gallicchio/GPiBridge/docs/images/board_bottom.png

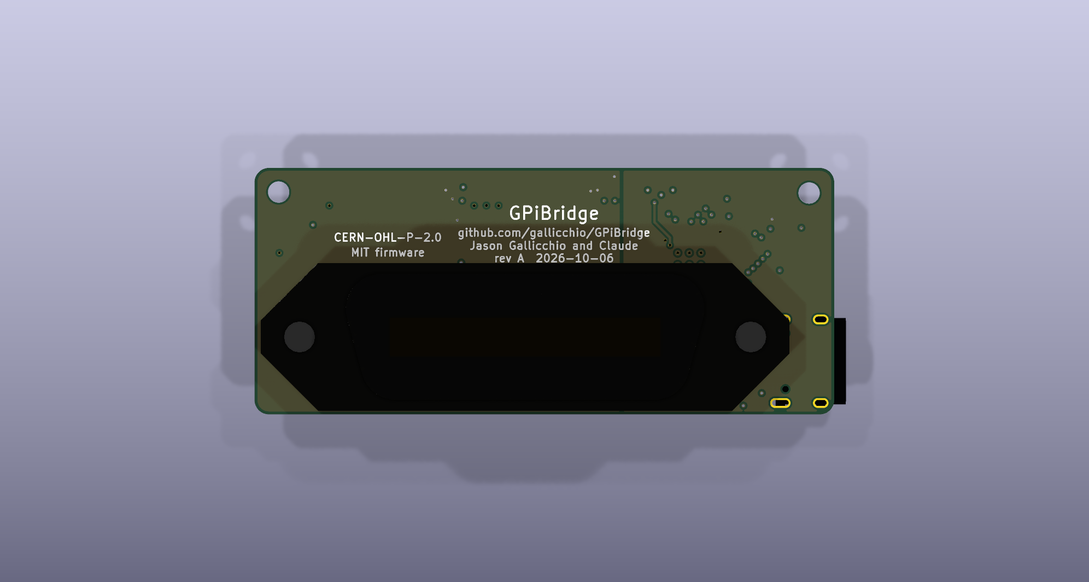
docs/images/board_bottom.png
