gallicchio/GPiBridge/docs/images/housing_front.png

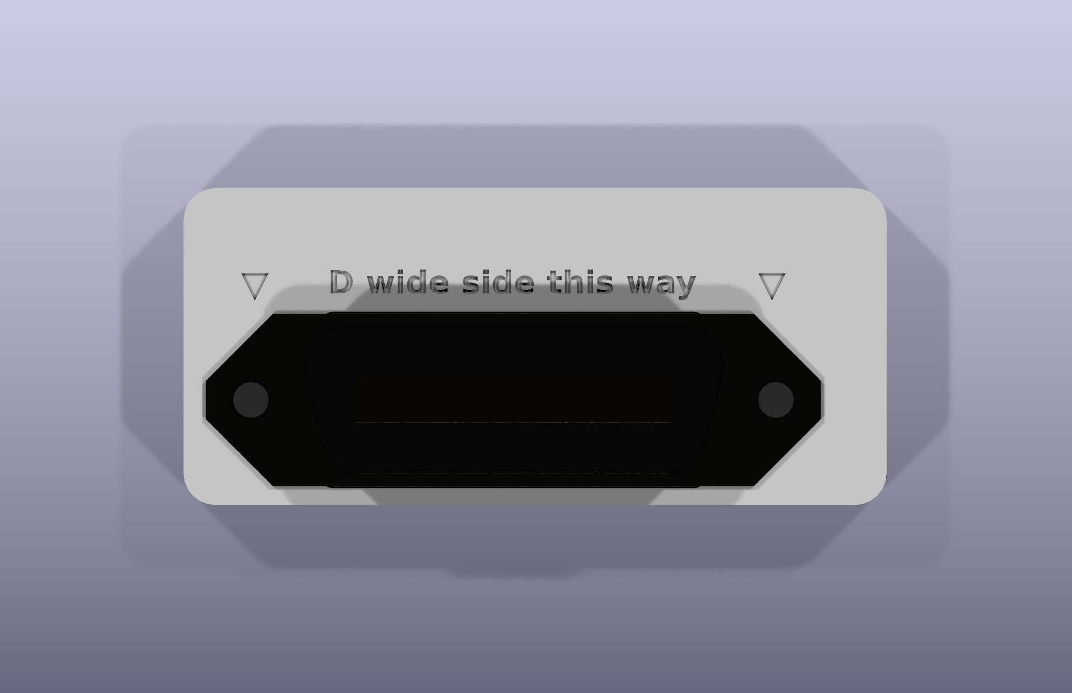
docs/images/housing_front.png
