gallicchio/GPiBridge/docs/images/housing_usb_end.png

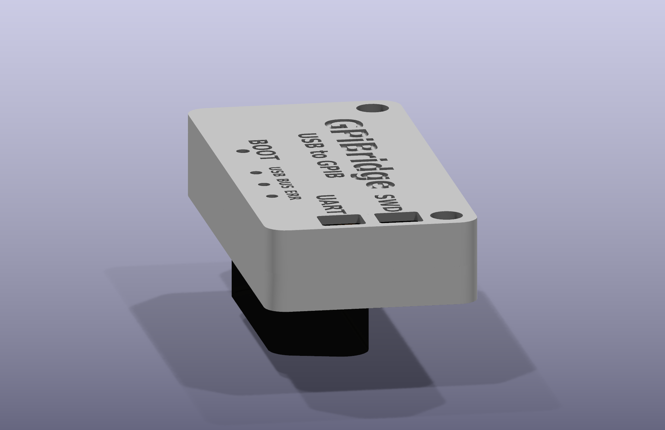
docs/images/housing_usb_end.png
