gallicchio/GPiBridge/docs/images/lite_schematic.png

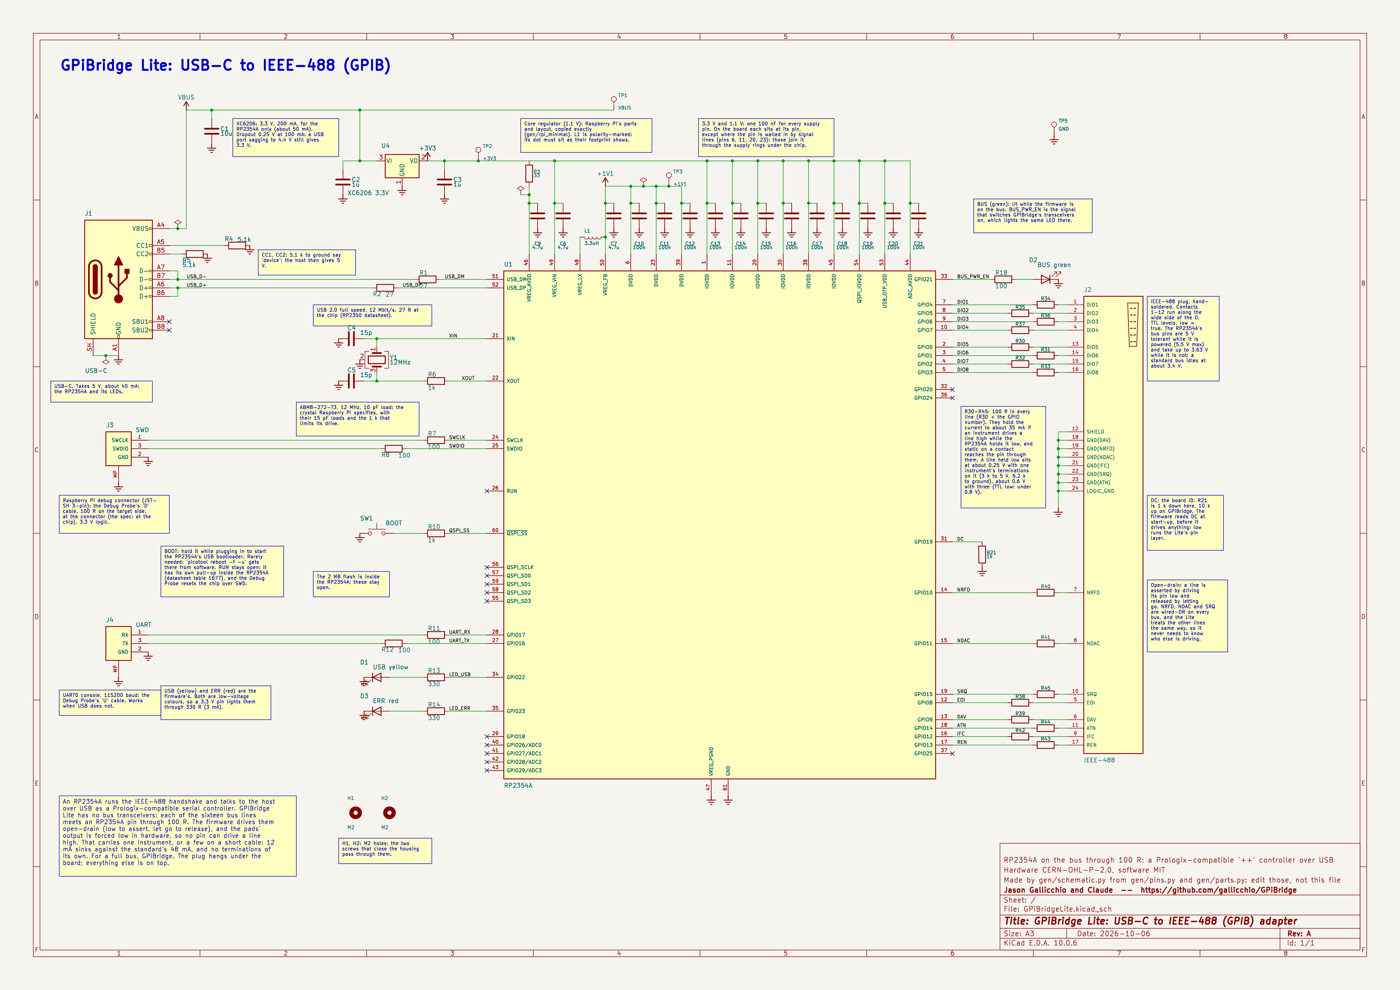
docs/images/lite_schematic.png
