gallicchio/GPiBridge/docs/images/schematic.png

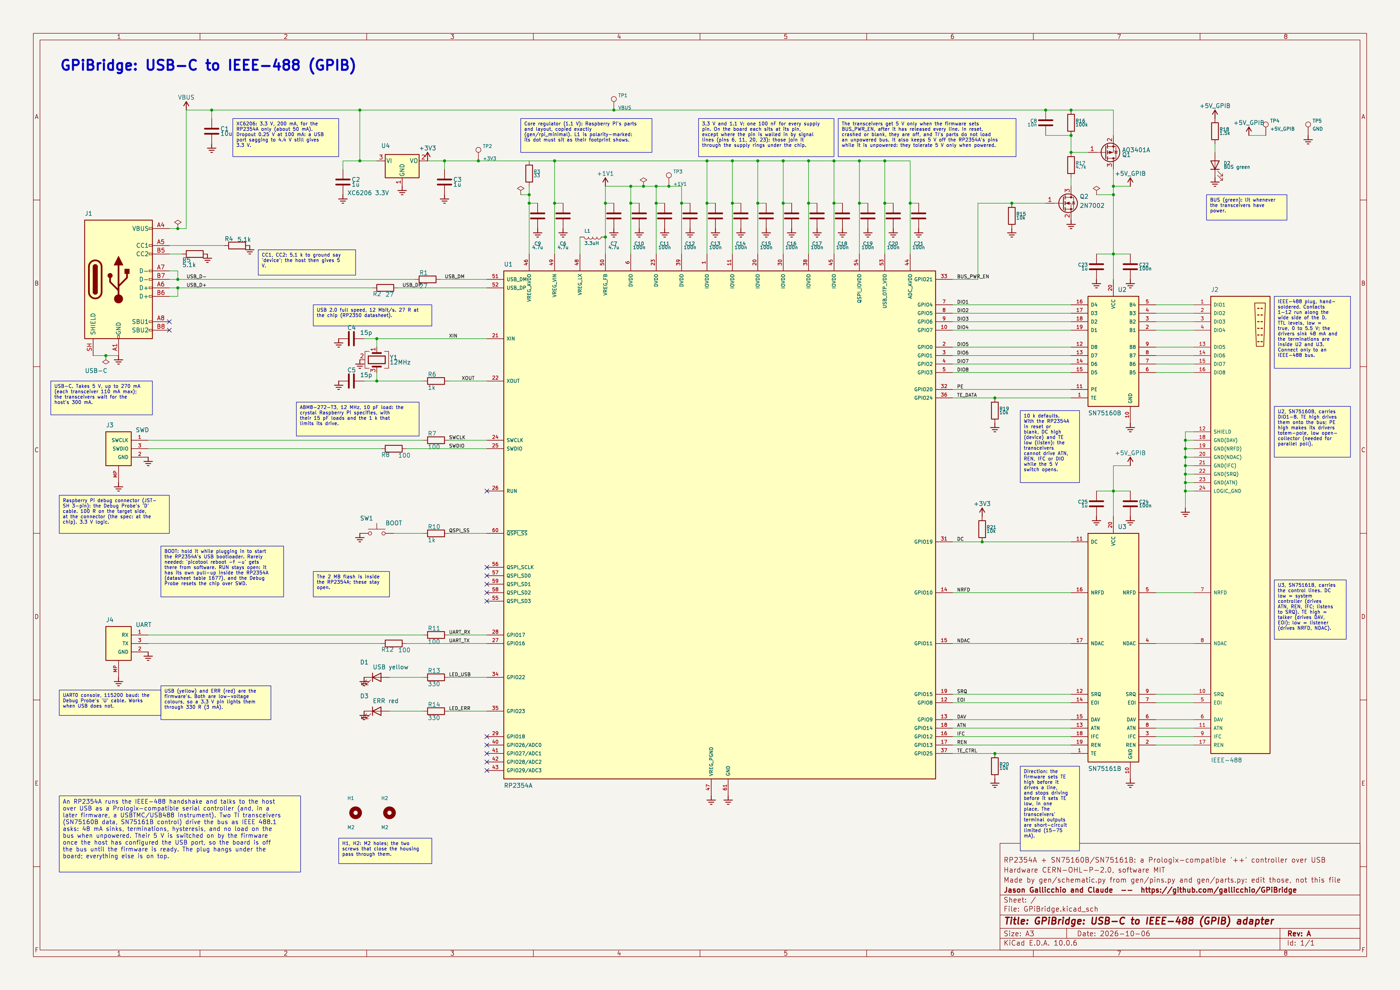
docs/images/schematic.png
