gallicchio/GPiBridge/enclosure/out/render_top.png

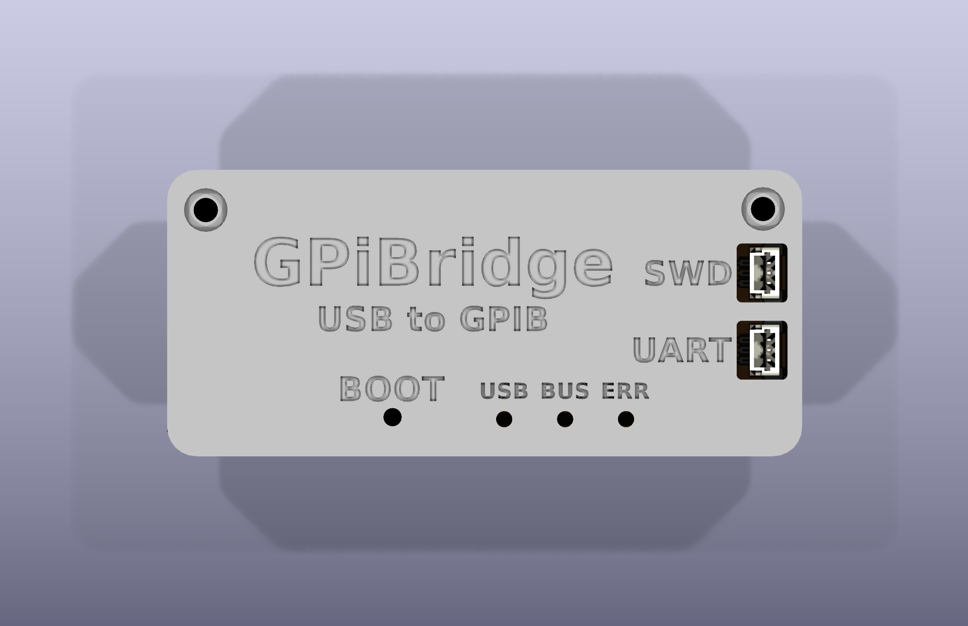
enclosure/out/render_top.png
