gallicchio/GPiBridge/mfg/release-lite/GPiBridgeLite_bom.csv

Comment | Designator | Footprint | LCSC Part #
100 | R7,R8,R11,R12,R18,R30,R31,R32,R33,R34,R35,R36,R37,R38,R39,R40,R41,R42,R43,R44,R45 | R_0402_1005Metric | C25076
100n | C10,C11,C12,C13,C14,C15,C16,C17,C18,C19,C20,C21 | C_0402_1005Metric | C1525
1k | R6,R10,R21 | R_0402_1005Metric | C11702
4.7u | C6,C7,C9 | C_0402_RPi_wide | C23733
15p | C4,C5 | C_0402_1005Metric | C1548
SWD/UART | J3,J4 | JST_SH_BM03B-SRSS-TB_1x03-1MP_P1.00mm_Vertical | C160389
27 | R1,R2 | R_0402_1005Metric | C25100
330 | R13,R14 | R_0402_1005Metric | C25104
5.1k | R4,R5 | R_0402_1005Metric | C25905
1u | C2,C3 | C_0402_1005Metric | C52923
USB-C | J1 | USB_C_Receptacle_HRO_TYPE-C-31-M-12 | C165948
10u | C1 | C_0603_1608Metric | C19702
12MHz | Y1 | Crystal_SMD_3225-4Pin_3.2x2.5mm | C20625731
USB yellow | D1 | LED_0805_2012Metric | C2296
BUS green | D2 | LED_0805_2012Metric | C2297
33 | R3 | R_0402_RPi | C25105
RP2354A | U1 | RP2350A_QFN-60_7x7mm_P0.4mm_RPi | C41378174
3.3uH | L1 | L_Abracon_AOTA-B201610_RPi | C42411119
XC6206 3.3V | U4 | SOT-23-3 | C5446
BOOT | SW1 | SW_SPST_TS-1088-xR020 | C720477
ERR red | D3 | LED_0805_2012Metric | C84256
