gallicchio/GPiBridge/enclosure/out/gpibridge_lid.step

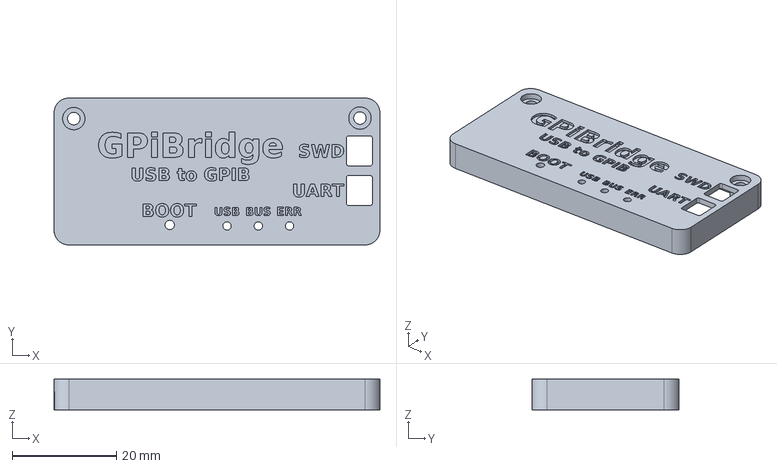
[picture p12: CAD file, 2026-10-07]
enclosure/out/gpibridge_lid.step
62.6 x 28.2 x 5.90 mm
