gallicchio/GPiBridge/enclosure/out/gpibridge_base.step

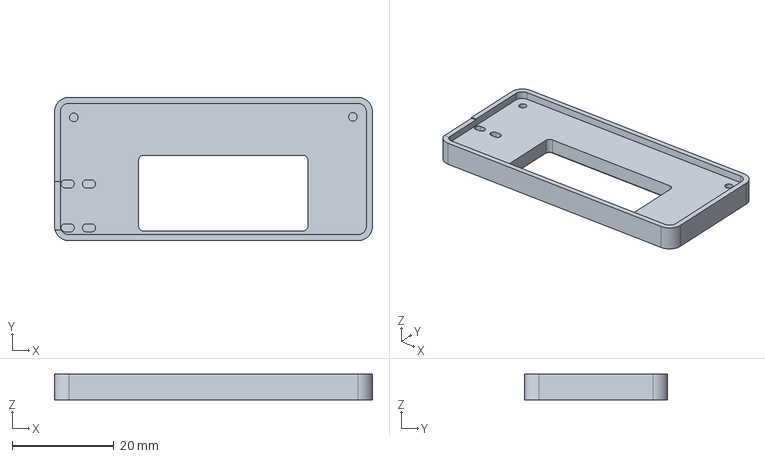
[picture p13: CAD file, 2026-10-07]
enclosure/out/gpibridge_base.step
62.6 x 28.2 x 5.10 mm
