gallicchio/GPiBridge/(list of files, cad)

Other CAD files:
enclosure/out/gpibridge_lite_lid.step
enclosure/out/gpibridge_base.stl
enclosure/out/gpibridge_lid.stl
enclosure/out/gpibridge_lite_lid.stl
