gallicchio/GPiBridge/docs/GPiBridge_schematic.pdf

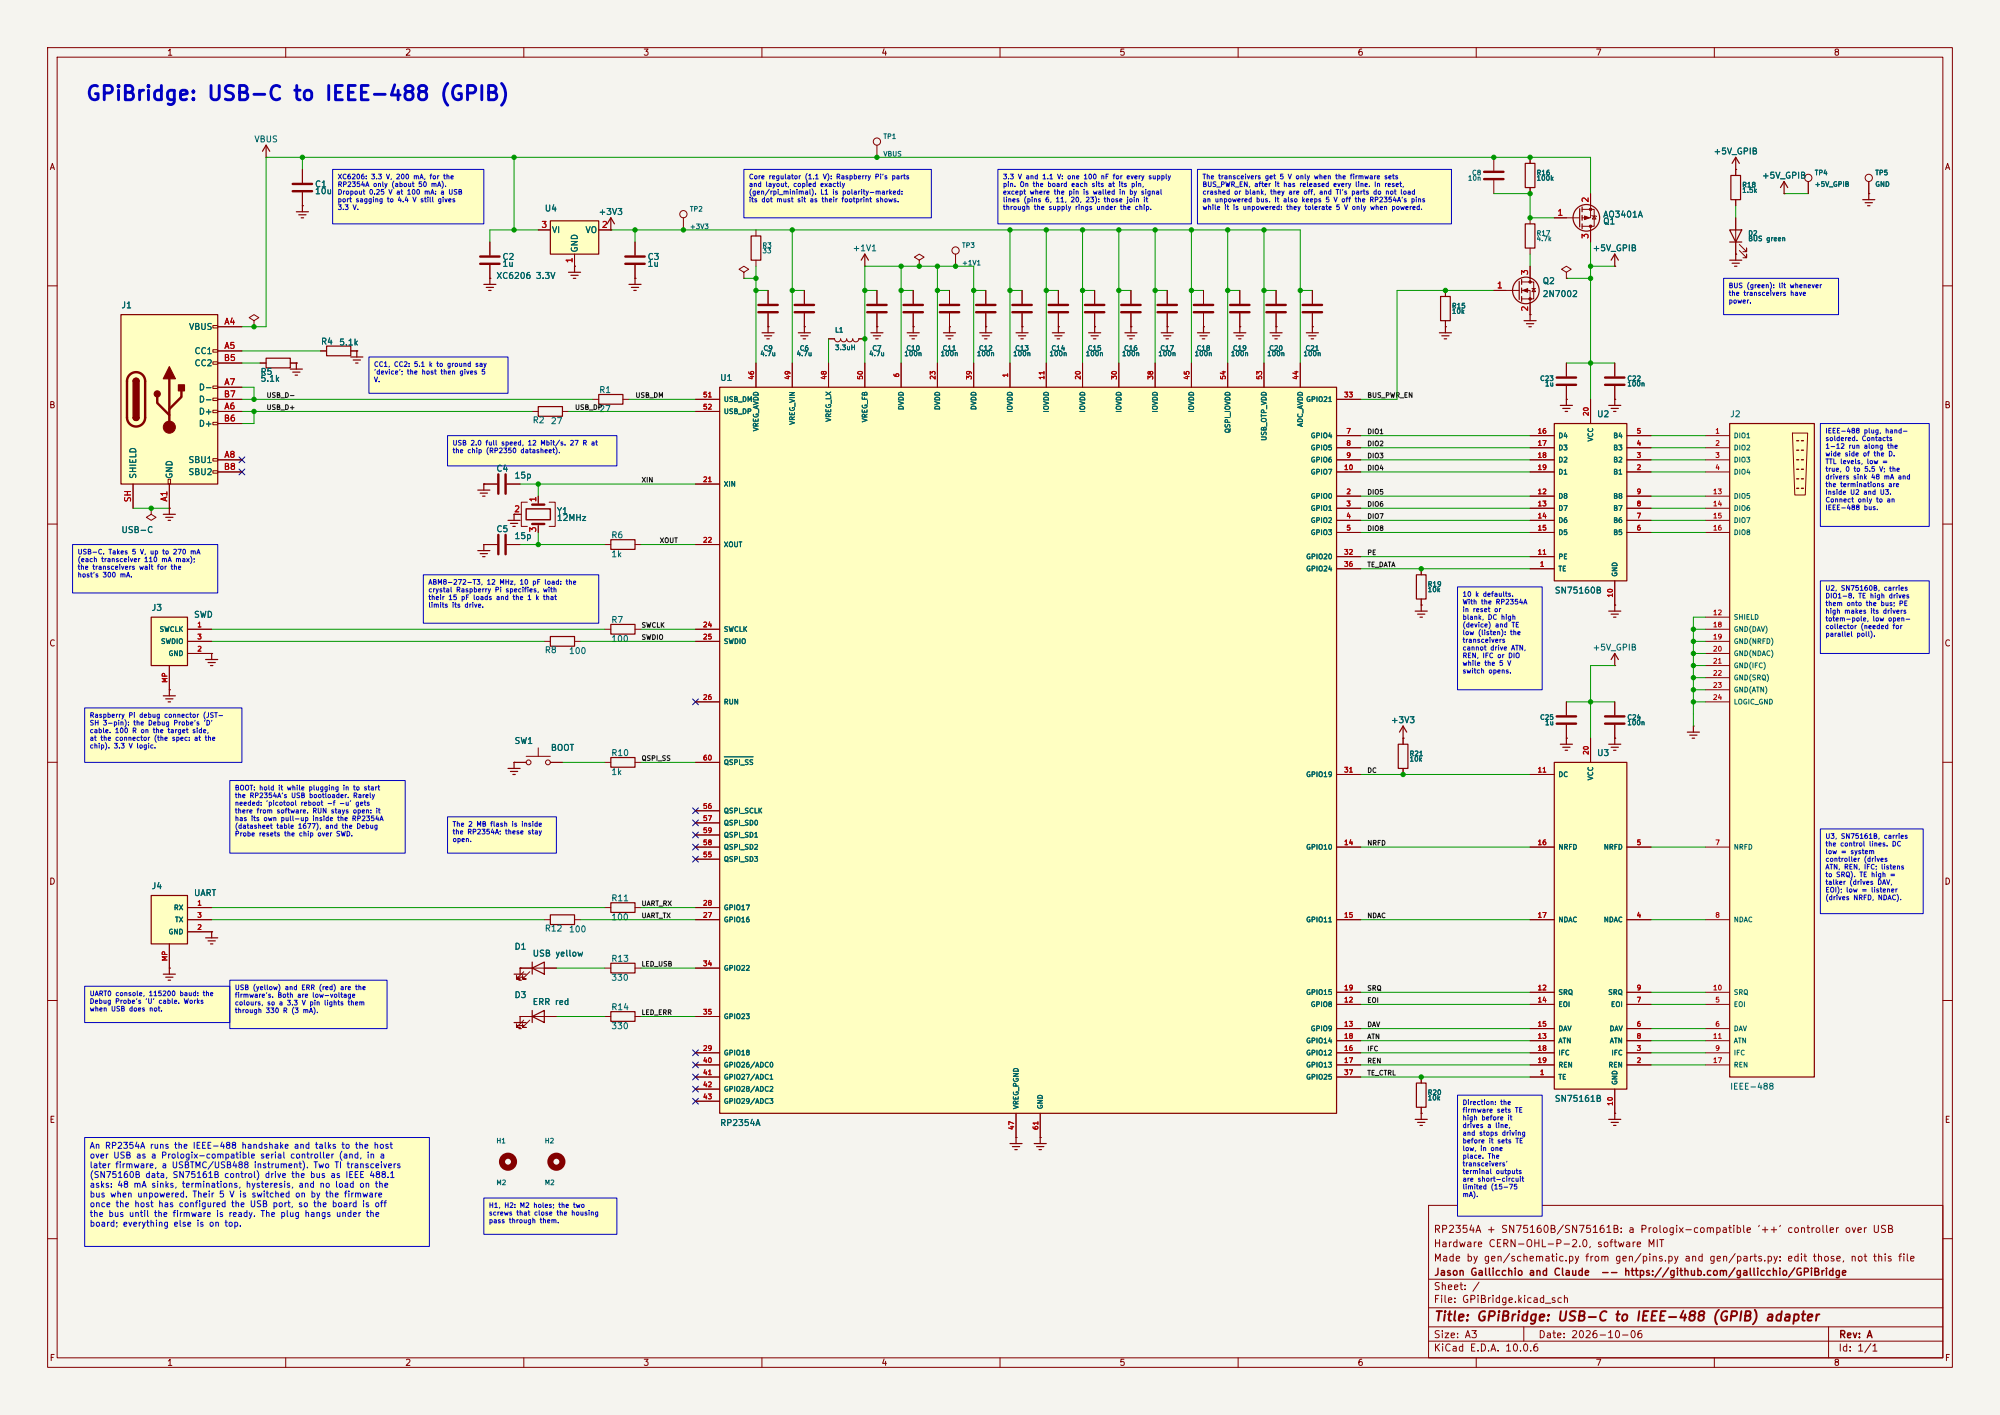
[picture p14: page 1]

GPiBridge: USB-C to IEEE-488 (GPIB)

the transceivers have power. XC6206: 3.3 V, 200 mA, for the RP2354A only (about 50 mA). Dropout 0.25 V at 100 mA: a USB

V. The transceivers get 5 V only when the firmware sets BUS_PWR_EN, after it has released every line. In reset, crashed or blank, they are off, and TI's parts do not load

Core regulator (1.1 V): Raspberry Pi's parts and layout, copied exactly

3.3 V and 1.1 V: one 100 nF for every supply pin. On the board each sits at its pin, except where the pin is walled in by signal

(gen/rpi_minimal). L1 is polarity-marked:

its dot must sit as their footprint shows. USB-C. Takes 5 V, up to 270 mA

port sagging to 4.4 V still gives 3.3 V.

through the supply rings under the chip. ABM8-272-T3, 12 MHz, 10 pF load: the

lines (pins 6, 11, 20, 23): those join it

CC1, CC2: 5.1 k to ground say
'device'; the host then gives 5
C5 15p C4 15p D1 USB yellow

IEEE-488 plug, hand-
soldered. Contacts 1-12 run along the wide side of the D. TTL levels, low =

true, 0 to 5.5 V; the drivers sink 48 mA and

the terminations are
inside U2 and U3. Connect only to an

crystal Raspberry Pi specifies, with
their 15 pF loads and the 1 k that
limits its drive.

in reset or blank, DC high

them onto the bus; PE
high makes its drivers
totem-pole, low open-
collector (needed for parallel poll).

(device) and TE
low (listen): the
transceivers cannot drive ATN, REN, IFC or DIO

switch opens. The 2 MB flash is inside

(datasheet table 1677), and the Debug Probe resets the chip over SWD. Raspberry Pi debug connector (JST-
SH 3-pin): the Debug Probe's 'D' cable. 100 R on the target side, at the connector (the spec: at the

C251u D3 ERR red D1 USB yellow

BOOT: hold it while plugging in to start
the RP2354A's USB bootloader. Rarely needed: 'picotool reboot -f -u' gets

there from software. RUN stays open: it has its own pull-up inside the RP2354A

the RP2354A; these stay open. An RP2354A runs the IEEE-488 handshake and talks to the host over USB as a Prologix-compatible serial controller (and, in a

the control lines. DC
low = system
controller (drives ATN, REN, IFC; listens

to SRQ). TE high =
talker (drives DAV, EOI); low = listener (drives NRFD, NDAC).

USB (yellow) and ERR (red) are the
firmware's. Both are low-voltage
colours, so a 3.3 V pin lights them
through 330 R (3 mA).

UART0 console, 115200 baud: the Debug Probe's 'U' cable. Works when USB does not.

firmware sets TE
high before it drives a line, and stops driving

before it sets TE
low, in one place. The

later firmware, a USBTMC/USB488 instrument). Two TI transceivers
(SN75160B data, SN75161B control) drive the bus as IEEE 488.1
asks: 48 mA sinks, terminations, hysteresis, and no load on the bus when unpowered. Their 5 V is switched on by the firmware once the host has configured the USB port, so the board is off

transceivers' terminal outputs are short-circuit

H1, H2: M2 holes; the two
screws that close the housing

the bus until the firmware is ready. The plug hangs under the board; everything else is on top.

RP2354A + SN75160B/SN75161B: a Prologix-compatible '++' controller over USB
Hardware CERN-OHL-P-2.0, software MIT
Made by gen/schematic.py from gen/pins.py and gen/parts.py: edit those, not this file
Jason Gallicchio and Claude -- https://github.com/gallicchio/GPiBridge
Sheet: /
File: GPiBridge.kicad_sch
Title: GPiBridge: USB-C to IEEE-488 (GPIB) adapter

Size: A3 | Rev: A | F Date: 2026-10-06
KiCad E.D.A. 10.0.6 | Id: 1/1
