gallicchio/GPiBridge/docs/GPiBridgeLite_schematic.pdf

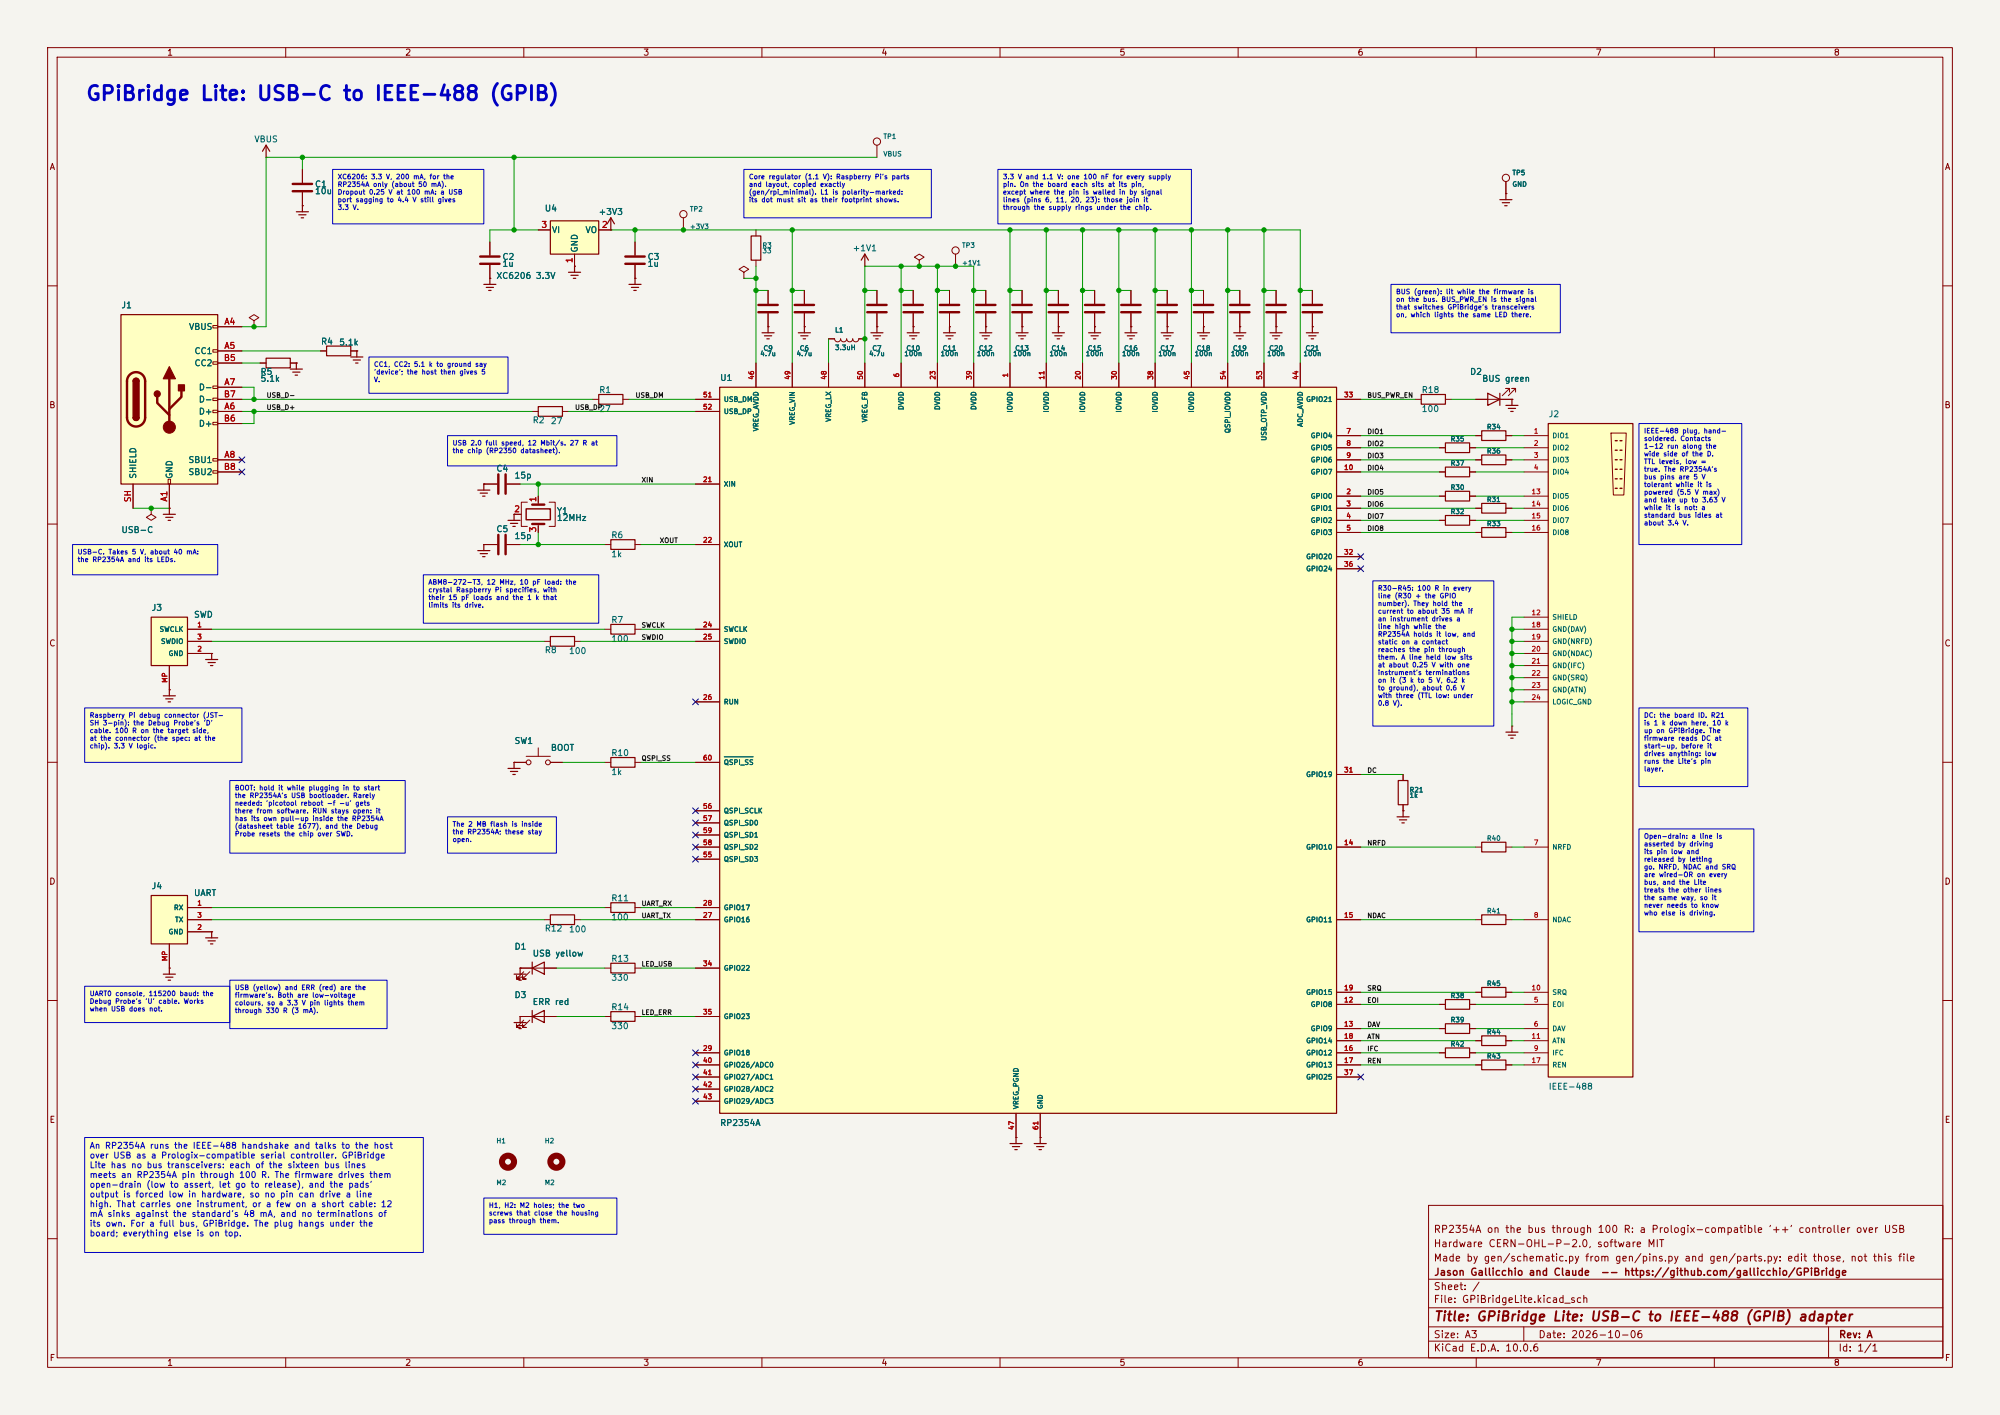
[picture p15: page 1]

chip). 3.3 V logic. GPiBridge Lite: USB-C to IEEE-488 (GPIB)

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

Core regulator (1.1 V): Raspberry Pi's parts and layout, copied exactly

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

(gen/rpi_minimal). L1 is polarity-marked:
its dot must sit as their footprint shows.

lines (pins 6, 11, 20, 23): those join it
through the supply rings under the chip.

CC1, CC2: 5.1 k to ground say
'device'; the host then gives 5
V. ABM8-272-T3, 12 MHz, 10 pF load: the

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

to ground), about 0.6 V with three (TTL low: under 0.8 V). USB 2.0 full speed, 12 Mbit/s. 27 R at

true. The RP2354A's bus pins are 5 V

tolerant while it is powered (5.5 V max) and take up to 3.63 V while it is not: a

standard bus idles at about 3.4 V.

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

line (R30 + the GPIO
number). They hold the
current to about 35 mA if an instrument drives a

line high while the RP2354A holds it low, and

static on a contact reaches the pin through

them. A line held low sits at about 0.25 V with one

instrument's terminations on it (3 k to 5 V, 6.2 k

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

is 1 k down here, 10 k up on GPiBridge. The

firmware reads DC at start-up, before it drives anything: low

runs the Lite's pin
layer.

who else is driving. BOOT: hold it while plugging in to start
the RP2354A's USB bootloader. Rarely needed: 'picotool reboot -f -u' gets

there from software. RUN stays open: it has its own pull-up inside the RP2354A
(datasheet table 1677), and the Debug Probe resets the chip over SWD.

the RP2354A; these stay open.

its pin low and
released by letting
go. NRFD, NDAC and SRQ
are wired-OR on every bus, and the Lite

treats the other lines
the same way, so it never needs to know

its own. For a full bus, GPiBridge. The plug hangs under the board; everything else is on top. USB (yellow) and ERR (red) are the
UART0 console, 115200 baud: the Debug Probe's 'U' cable. Works when USB does not. An RP2354A runs the IEEE-488 handshake and talks to the host over USB as a Prologix-compatible serial controller. GPiBridge

firmware's. Both are low-voltage
colours, so a 3.3 V pin lights them

Lite has no bus transceivers: each of the sixteen bus lines meets an RP2354A pin through 100 R. The firmware drives them

open-drain (low to assert, let go to release), and the pads'
output is forced low in hardware, so no pin can drive a line high. That carries one instrument, or a few on a short cable: 12 mA sinks against the standard's 48 mA, and no terminations of

H1, H2: M2 holes; the two
screws that close the housing
pass through them.

RP2354A on the bus through 100 R: a Prologix-compatible '++' controller over USB
Hardware CERN-OHL-P-2.0, software MIT
Made by gen/schematic.py from gen/pins.py and gen/parts.py: edit those, not this file
Jason Gallicchio and Claude -- https://github.com/gallicchio/GPiBridge
Sheet: /
File: GPiBridgeLite.kicad_sch
Title: GPiBridge Lite: USB-C to IEEE-488 (GPIB) adapter

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
