gallicchio/GPiBridge/mfg/release-lite/GPiBridgeLite_assembly_bottom.pdf

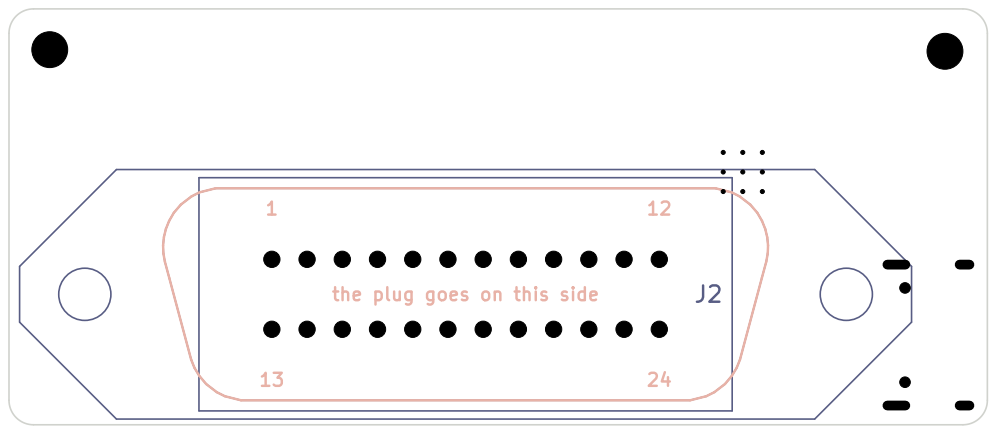
[picture p16: page 1]
