gallicchio/GPiBridge/mfg/release-lite/GPiBridgeLite_assembly_top.pdf

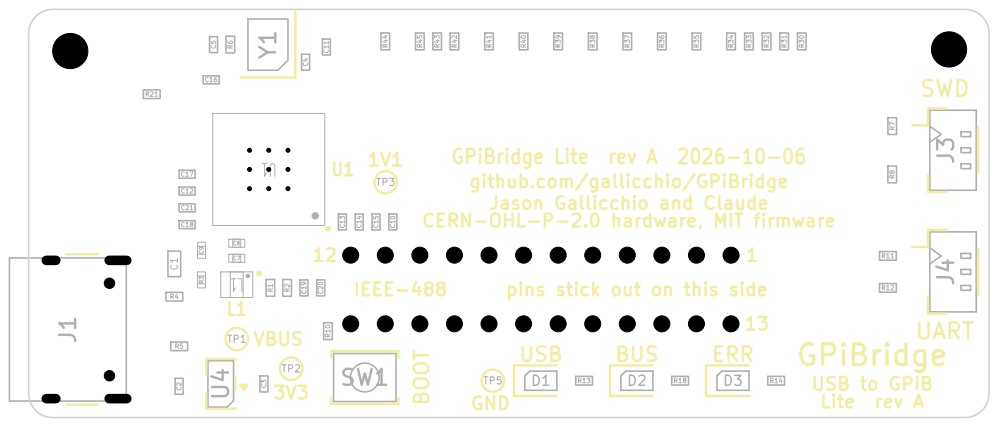
[picture p17: page 1]

github.com/gallicchio/GPiBridge
Jason Gallicchio and Claude CERN-OHL-P-2.0 hardware, MIT firmware pins stick out on this side1
