gallicchio/GPiBridge/mfg/release/GPiBridge_assembly_bottom.pdf

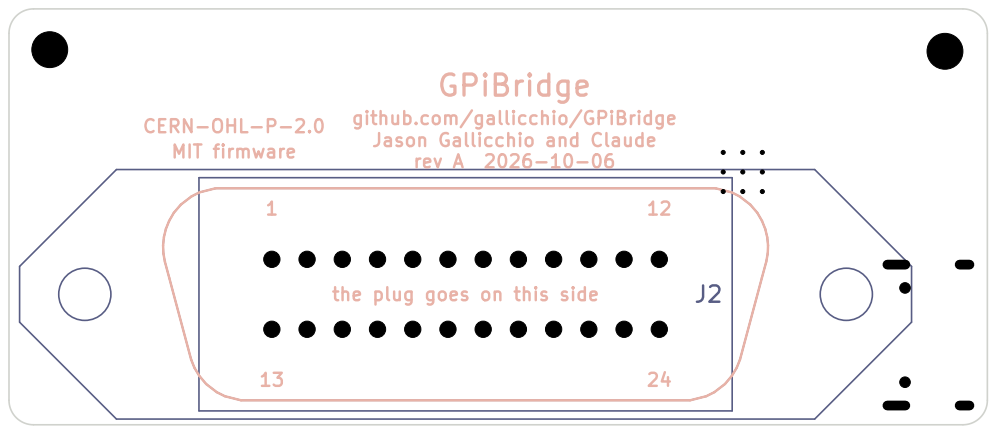
[picture p18: page 1]

github.com/gallicchio/GPiBridge
Jason Gallicchio and Claude
rev A 2026-10-06
