gallicchio/GPiBridge/mfg/release/GPiBridge_assembly_top.pdf

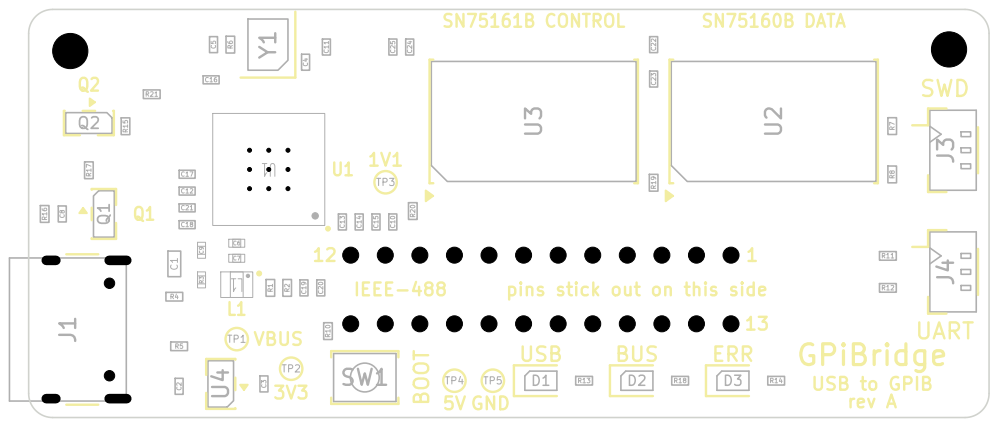
[picture p19: page 1]

pins stick out on this side1
