gallicchio/GPiBridge/hardware/GPiBridge.kicad_pcb

## KiCad design hardware/GPiBridge.kicad_pcb (2026-10-07)

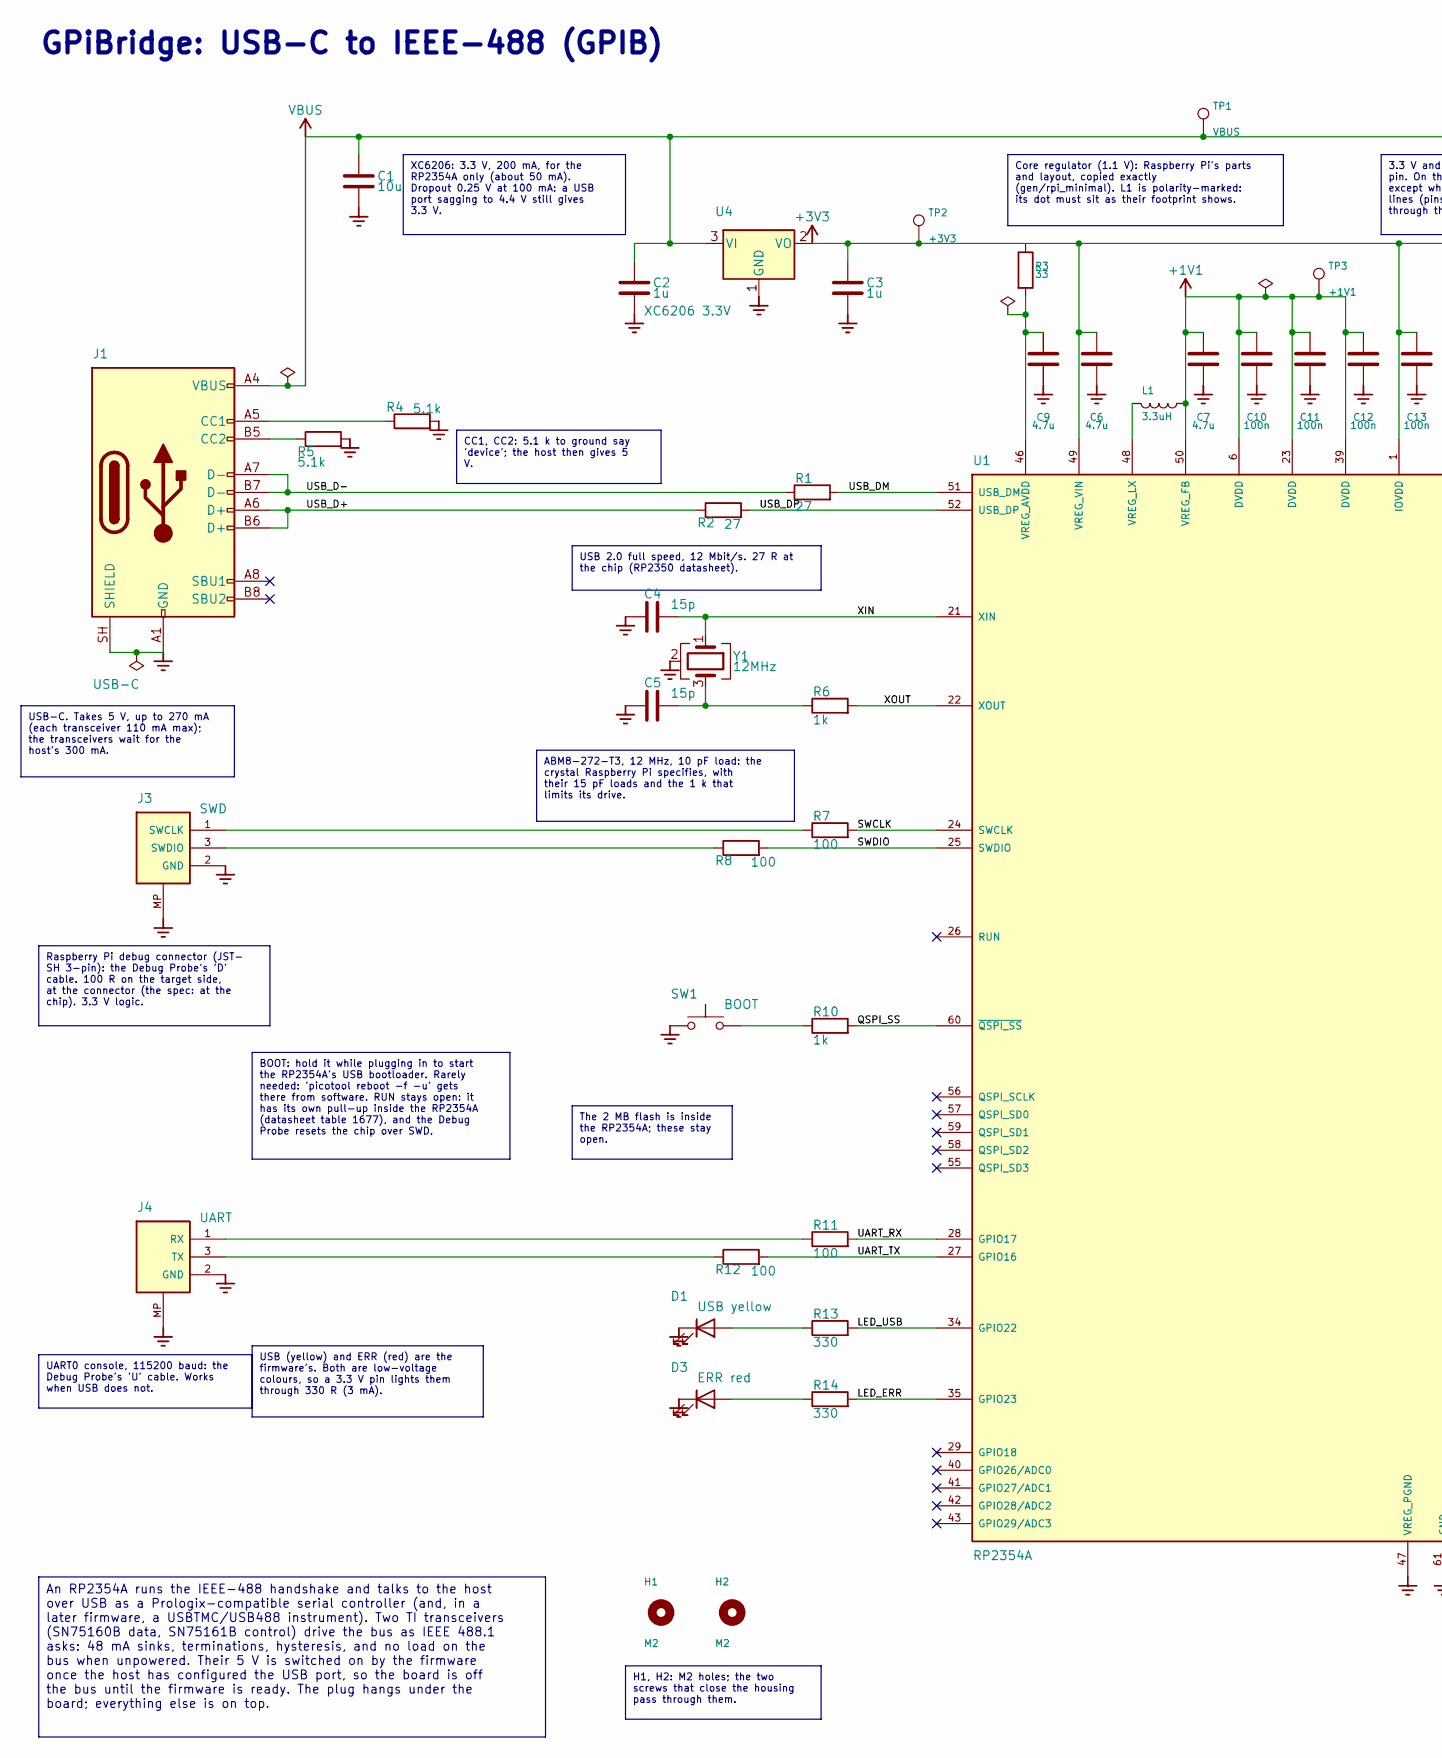
[picture p20: schematic GPiBridge.kicad_sch, GPiBridge: USB-C to IEEE-488 (GPIB) adapter, part in row 1, column 1]

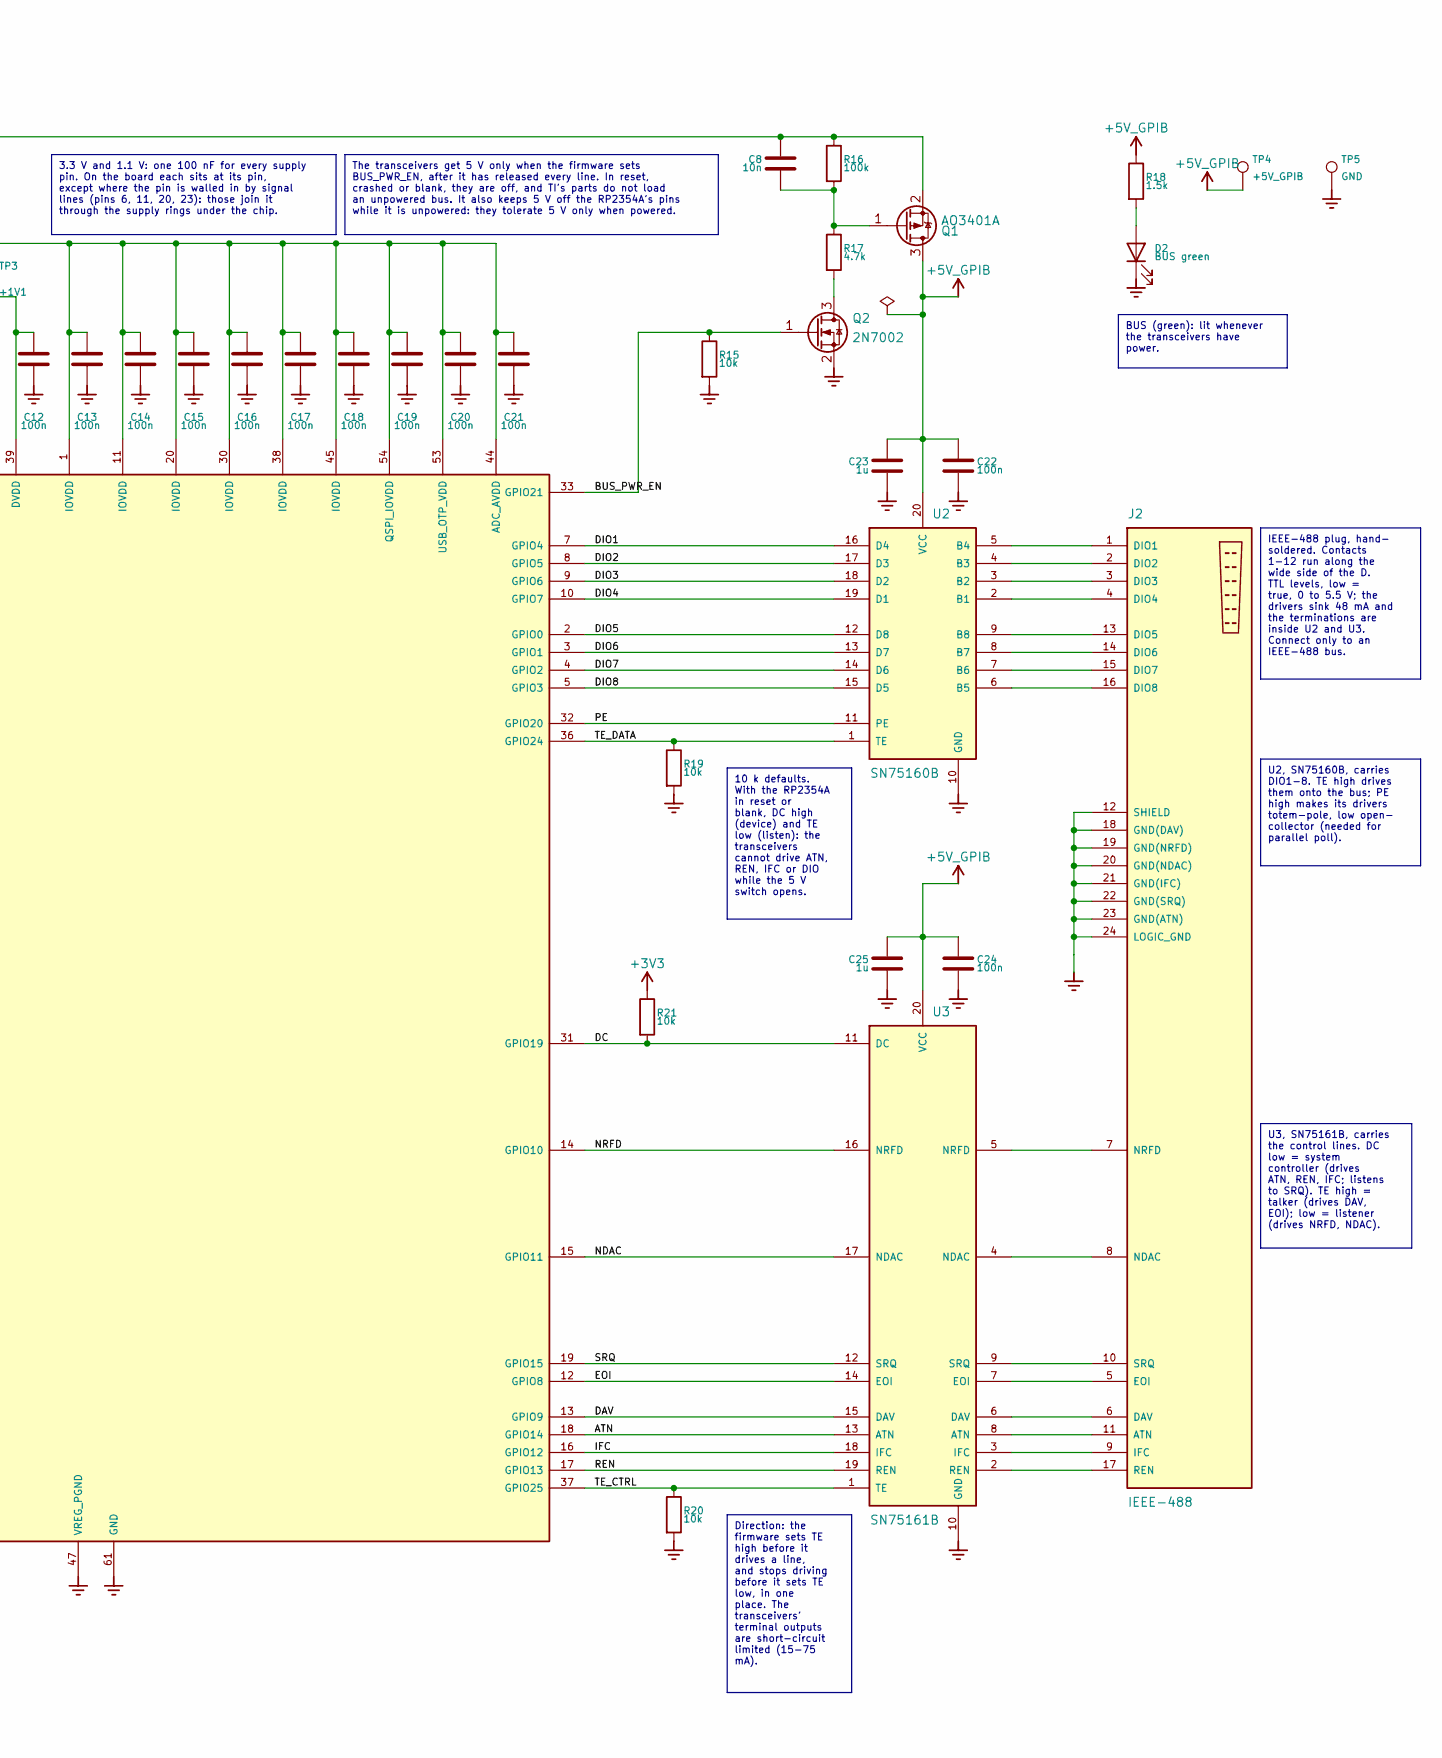
[picture p21: schematic GPiBridge.kicad_sch, GPiBridge: USB-C to IEEE-488 (GPIB) adapter, part in row 1, column 2]

Parts:
C1: 10u; C_0603_1608Metric; MPN CL10A106KP8NNNC; LCSC C19702
C2, C3, C23, C25: 1u; C_0402_1005Metric; MPN CL05A105KA5NQNC; LCSC C52923
C4, C5: 15p; C_0402_1005Metric; MPN 0402CG150J500NT; LCSC C1548
C6, C7: 4.7u; C_0402_RPi_wide; MPN CL05A475MP5NRNC; LCSC C23733
C8: 10n; C_0402_1005Metric; MPN CL05B103KB5NNNC; LCSC C15195
C9: 4.7u; C_0402_RPi; MPN CL05A475MP5NRNC; LCSC C23733
C10, C11, C12, C13, C14, C15, C16, C17, C18, C19, C20, C21, C22, C24: 100n; C_0402_1005Metric; MPN CL05B104KO5NNNC; LCSC C1525
D1: USB yellow; LED_0805_2012Metric; MPN KT-0805Y; LCSC C2296
D2: BUS green; LED_0805_2012Metric; MPN KT-0805G; LCSC C2297
D3: ERR red; LED_0805_2012Metric; MPN NCD0805R1; LCSC C84256
H1, H2: M2; MountingHole_2.2mm_M2
J1: USB-C; USB_C_Receptacle_HRO_TYPE-C-31-M-12; MPN TYPE-C-31-M-12; LCSC C165948
J2: IEEE-488; IEEE488_Plug_24P_P2.16mm_DIP_Solder; MPN NorComp 111-024-113L001, or any 24-pin 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
J3: SWD; JST_SH_BM03B-SRSS-TB_1x03-1MP_P1.00mm_Vertical; MPN BM03B-SRSS-TB(LF)(SN); LCSC C160389
J4: UART; JST_SH_BM03B-SRSS-TB_1x03-1MP_P1.00mm_Vertical; MPN BM03B-SRSS-TB(LF)(SN); LCSC C160389
L1: 3.3uH; L_Abracon_AOTA-B201610_RPi; MPN AOTA-B201610S3R3-101-T; LCSC C42411119
Q1: AO3401A; SOT-23; MPN AO3401A; LCSC C15127
Q2: 2N7002; SOT-23; MPN 2N7002; LCSC C8545
R1, R2: 27; R_0402_1005Metric; MPN 0402WGF270JTCE; LCSC C25100
R3: 33; R_0402_RPi; MPN 0402WGF330JTCE; LCSC C25105
R4, R5: 5.1k; R_0402_1005Metric; MPN 0402WGF5101TCE; LCSC C25905
R6, R10: 1k; R_0402_1005Metric; MPN 0402WGF1001TCE; LCSC C11702
R7, R8, R11, R12: 100; R_0402_1005Metric; MPN 0402WGF1000TCE; LCSC C25076
R13, R14: 330; R_0402_1005Metric; MPN 0402WGF3300TCE; LCSC C25104
R15, R19, R20, R21: 10k; R_0402_1005Metric; MPN 0402WGF1002TCE; LCSC C25744
R16: 100k; R_0402_1005Metric; MPN 0402WGF1003TCE; LCSC C25741
R17: 4.7k; R_0402_1005Metric; MPN 0402WGF4701TCE; LCSC C25900
R18: 1.5k; R_0402_1005Metric; MPN 0402WGF1501TCE; LCSC C25867
SW1: BOOT; SW_SPST_TS-1088-xR020; MPN TS-1088-AR02016; LCSC C720477
TP1: VBUS; TestPoint_Pad_D1.0mm
TP2: +3V3; TestPoint_Pad_D1.0mm
TP3: +1V1; TestPoint_Pad_D1.0mm
TP4: +5V_GPIB; TestPoint_Pad_D1.0mm
TP5: GND; TestPoint_Pad_D1.0mm
U1: RP2354A; RP2350A_QFN-60_7x7mm_P0.4mm_RPi; MPN RP2354A; LCSC C41378174
U2: SN75160B; SOIC-20W_7.5x12.8mm_P1.27mm; MPN SN75160BDWR; LCSC C882412
U3: SN75161B; SOIC-20W_7.5x12.8mm_P1.27mm; MPN SN75161BDWR; LCSC C2671348
U4: XC6206 3.3V; SOT-23-3; MPN XC6206P332MR-G; LCSC C5446
Y1: 12MHz; Crystal_SMD_3225-4Pin_3.2x2.5mm; MPN ABM8-272-T3; LCSC C20625731

Connections:
+1V1: C7.1, C10.1, C11.1, C12.1, L1.1, TP3.1, U1.6 (DVDD), U1.23 (DVDD), U1.39 (DVDD), U1.50 (VREG_FB)
+3V3: C3.1, C6.1, C13.1, C14.1, C15.1, C16.1, C17.1, C18.1, C19.1, C20.1, C21.1, R3.1, R21.1, TP2.1, U1.1 (IOVDD), U1.11 (IOVDD), U1.20 (IOVDD), U1.30 (IOVDD), U1.38 (IOVDD), U1.44 (ADC_AVDD), U1.45 (IOVDD), U1.49 (VREG_VIN), U1.53 (USB_OTP_VDD), U1.54 (QSPI_IOVDD), U4.2 (VO)
+5V_GPIB: C22.1, C23.1, C24.1, C25.1, Q1.3 (D), R18.1, TP4.1, U2.20 (VCC), U3.20 (VCC)
/ATN: U1.18 (GPIO14), U3.13 (ATN)
/BUS_PWR_EN: Q2.1 (G), R15.1, U1.33 (GPIO21)
/DAV: U1.13 (GPIO9), U3.15 (DAV)
/DC: R21.2, U1.31 (GPIO19), U3.11 (DC)
/DIO1: U1.7 (GPIO4), U2.16 (D4)
/DIO2: U1.8 (GPIO5), U2.17 (D3)
/DIO3: U1.9 (GPIO6), U2.18 (D2)
/DIO4: U1.10 (GPIO7), U2.19 (D1)
/DIO5: U1.2 (GPIO0), U2.12 (D8)
/DIO6: U1.3 (GPIO1), U2.13 (D7)
/DIO7: U1.4 (GPIO2), U2.14 (D6)
/DIO8: U1.5 (GPIO3), U2.15 (D5)
/EOI: U1.12 (GPIO8), U3.14 (EOI)
/IFC: U1.16 (GPIO12), U3.18 (IFC)
/LED_ERR: R14.2, U1.35 (GPIO23)
/LED_USB: R13.2, U1.34 (GPIO22)
/NDAC: U1.15 (GPIO11), U3.17 (NDAC)
/NRFD: U1.14 (GPIO10), U3.16 (NRFD)
/PE: U1.32 (GPIO20), U2.11 (PE)
/QSPI_SS: R10.2, U1.60 (~QSPI_SS)
/REN: U1.17 (GPIO13), U3.19 (REN)
/SRQ: U1.19 (GPIO15), U3.12 (SRQ)
/SWCLK: R7.2, U1.24 (SWCLK)
/SWDIO: R8.2, U1.25 (SWDIO)
/TE_CTRL: R20.1, U1.37 (GPIO25), U3.1 (TE)
/TE_DATA: R19.1, U1.36 (GPIO24), U2.1 (TE)
/UART_RX: R11.2, U1.28 (GPIO17)
/UART_TX: R12.2, U1.27 (GPIO16)
/USB_D+: J1.A6 (D+), J1.B6 (D+), R2.1
/USB_D-: J1.A7 (D-), J1.B7 (D-), R1.1
/USB_DM: R1.2, U1.51 (USB_DM)
/USB_DP: R2.2, U1.52 (USB_DP)
/XIN: C4.2, U1.21 (XIN), Y1.1
/XOUT: R6.2, U1.22 (XOUT)
GND: C1.2, C2.2, C3.2, C4.1, C5.1, C6.2, C7.2, C9.2, C10.2, C11.2, C12.2, C13.2, C14.2, C15.2, C16.2, C17.2, C18.2, C19.2, C20.2, C21.2, C22.2, C23.2, C24.2, C25.2, D1.1 (K), D2.1 (K), D3.1 (K), J1.A1 (GND), J1.A12 (GND), J1.B1 (GND), J1.B12 (GND), J1.SH (SHIELD), J2.12 (SHIELD), J2.18 (GND(DAV)), J2.19 (GND(NRFD)), J2.20 (GND(NDAC)), J2.21 (GND(IFC)), J2.22 (GND(SRQ)), J2.23 (GND(ATN)), J2.24 (LOGIC_GND), J3.2 (GND), J3.MP, J4.2 (GND), J4.MP, Q2.2 (S), R4.2, R5.2, R15.2, R19.2, R20.2, SW1.1, TP5.1, U1.47 (VREG_PGND), U1.61 (GND), U2.10 (GND), U3.10 (GND), U4.1 (GND), Y1.2 (G), Y1.4 (G)
unnamed: C5.2, R6.1, Y1.3
unnamed: D1.2 (A), R13.1
unnamed: D2.2 (A), R18.2
unnamed: D3.2 (A), R14.1
unnamed: J1.A5 (CC1), R4.1
unnamed: J1.B5 (CC2), R5.1
unnamed: J2.11 (ATN), U3.8 (ATN)
unnamed: J2.6 (DAV), U3.6 (DAV)
unnamed: J2.1 (DIO1), U2.5 (B4)
unnamed: J2.2 (DIO2), U2.4 (B3)
unnamed: J2.3 (DIO3), U2.3 (B2)
unnamed: J2.4 (DIO4), U2.2 (B1)
unnamed: J2.13 (DIO5), U2.9 (B8)
unnamed: J2.14 (DIO6), U2.8 (B7)
unnamed: J2.15 (DIO7), U2.7 (B6)
unnamed: J2.16 (DIO8), U2.6 (B5)
unnamed: J2.5 (EOI), U3.7 (EOI)
unnamed: J2.9 (IFC), U3.3 (IFC)
unnamed: J2.8 (NDAC), U3.4 (NDAC)
unnamed: J2.7 (NRFD), U3.5 (NRFD)
unnamed: J2.17 (REN), U3.2 (REN)
unnamed: J2.10 (SRQ), U3.9 (SRQ)
unnamed: J3.1 (SWCLK), R7.1
unnamed: J3.3 (SWDIO), R8.1
unnamed: J4.1 (RX), R11.1
unnamed: J4.3 (TX), R12.1
unnamed: C8.2, Q1.1 (G), R16.2, R17.1
unnamed: Q2.3 (D), R17.2
unnamed: R10.1, SW1.2
unnamed: C9.1, R3.2, U1.46 (VREG_AVDD)
unnamed: L1.2, U1.48 (VREG_LX)
VBUS: C1.1, C2.1, C8.1, J1.A4 (VBUS), J1.A9 (VBUS), J1.B4 (VBUS), J1.B9 (VBUS), Q1.2 (S), R16.1, TP1.1, U4.3 (VI)

Notes on the sheet:
GPiBridge: USB-C to IEEE-488 (GPIB)
The transceivers get 5 V only when the firmware sets BUS_PWR_EN, after it has released every line. In reset, crashed or blank, they are off, and TI's parts do not load an unpowered bus. It also keeps 5 V off the RP2354A's pins while it is unpowered: they tolerate 5 V only when powered.
H1, H2: M2 holes; the two screws that close the housing pass through them.
USB-C. Takes 5 V, up to 270 mA (each transceiver 110 mA max); the transceivers wait for the host's 300 mA.
ABM8-272-T3, 12 MHz, 10 pF load: the crystal Raspberry Pi specifies, with their 15 pF loads and the 1 k that limits its drive.
The 2 MB flash is inside the RP2354A; these stay open.
CC1, CC2: 5.1 k to ground say 'device'; the host then gives 5 V.
IEEE-488 plug, hand- soldered. Contacts 1-12 run along the wide side of the D. TTL levels, low = true, 0 to 5.5 V; the drivers sink 48 mA and the terminations are inside U2 and U3. Connect only to an IEEE-488 bus.
An RP2354A runs the IEEE-488 handshake and talks to the host over USB as a Prologix-compatible serial controller (and, in a later firmware, a USBTMC/USB488 instrument). Two TI transceivers (SN75160B data, SN75161B control) drive the bus as IEEE 488.1 asks: 48 mA sinks, terminations, hysteresis, and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
BUS (green): lit whenever the transceivers have power.
10 k defaults. With the RP2354A in reset or blank, DC high (device) and TE low (listen): the transceivers cannot drive ATN, REN, IFC or DIO while the 5 V switch opens.
Core regulator (1.1 V): Raspberry Pi's parts and layout, copied exactly (gen/rpi_minimal). L1 is polarity-marked: its dot must sit as their footprint shows.
U2, SN75160B, carries DIO1-8. TE high drives them onto the bus; PE high makes its drivers totem-pole, low open- collector (needed for parallel poll).
USB (yellow) and ERR (red) are the firmware's. Both are low-voltage colours, so a 3.3 V pin lights them through 330 R (3 mA).
3.3 V and 1.1 V: one 100 nF for every supply pin. On the board each sits at its pin, except where the pin is walled in by signal lines (pins 6, 11, 20, 23): those join it through the supply rings under the chip.
USB 2.0 full speed, 12 Mbit/s. 27 R at the chip (RP2350 datasheet).
XC6206: 3.3 V, 200 mA, for the RP2354A only (about 50 mA). Dropout 0.25 V at 100 mA: a USB port sagging to 4.4 V still gives 3.3 V.
Direction: the firmware sets TE high before it drives a line, and stops driving before it sets TE low, in one place. The transceivers' terminal outputs are short-circuit limited (15-75 mA).
UART0 console, 115200 baud: the Debug Probe's 'U' cable. Works when USB does not.
BOOT: hold it while plugging in to start the RP2354A's USB bootloader. Rarely needed: 'picotool reboot -f -u' gets there from software. RUN stays open: it has its own pull-up inside the RP2354A (datasheet table 1677), and the Debug Probe resets the chip over SWD.
U3, SN75161B, carries the control lines. DC low = system controller (drives ATN, REN, IFC; listens to SRQ). TE high = talker (drives DAV, EOI); low = listener (drives NRFD, NDAC).
Raspberry Pi debug connector (JST- SH 3-pin): the Debug Probe's 'D' cable. 100 R on the target side, at the connector (the spec: at the chip). 3.3 V logic.

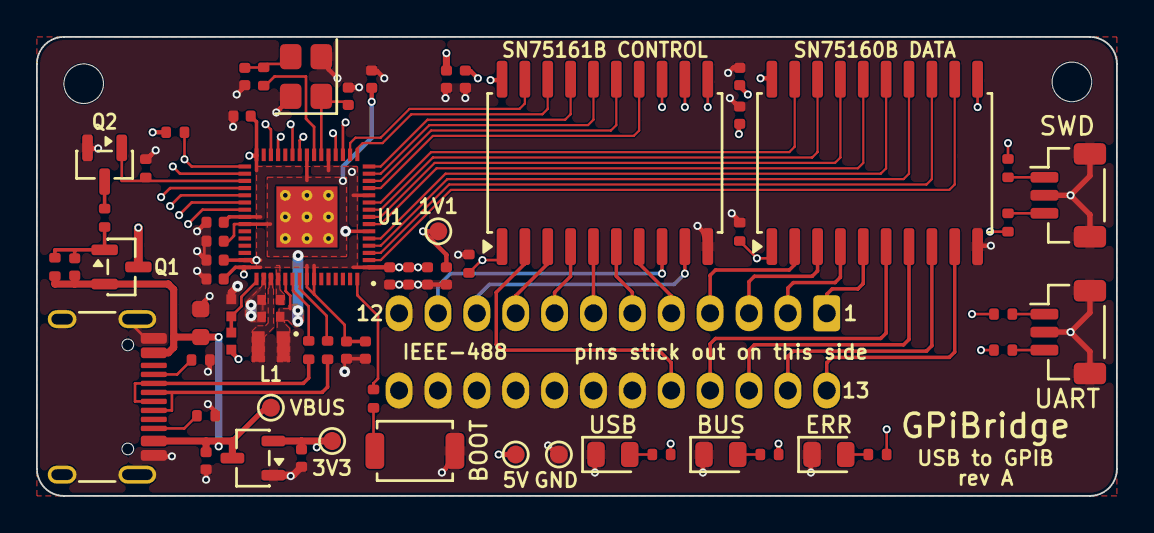
[picture p22: board GPiBridge.kicad_pcb from above]

Board: 4 copper layers, 60.0 x 25.5 mm, 68 parts (1 on the bottom side), 70 nets.
