gallicchio/GPiBridge/firmware/boards/gpibridge.h

/* gpibridge.h: the Pico SDK's board description of GPiBridge rev A.
 * RP2354A: the RP2350A die (QFN-60) with 2 MB of flash in the package. */
#ifndef _BOARDS_GPIBRIDGE_H
#define _BOARDS_GPIBRIDGE_H

#define GPIBRIDGE_REV_A
#define PICO_RP2350A 1                       /* the QFN-60 package: GPIO 0-29 */

/* UART0 on GPIO16/17: the UART debug connector J4 (Raspberry Pi debug pinout) */
#define PICO_DEFAULT_UART 0
#define PICO_DEFAULT_UART_TX_PIN 16
#define PICO_DEFAULT_UART_RX_PIN 17

/* the yellow USB LED */
#define PICO_DEFAULT_LED_PIN 22

/* 12 MHz crystal (ABM8-272-T3, as on Raspberry Pi's boards): the SDK's default XOSC */
#define PICO_XOSC_STARTUP_DELAY_MULTIPLIER 64

/* the flash stacked in the package */
#define PICO_BOOT_STAGE2_CHOOSE_W25Q080 1
#define PICO_FLASH_SPI_CLKDIV 2
#define PICO_FLASH_SIZE_BYTES (2 * 1024 * 1024)

#define PICO_RP2350_A2_SUPPORTED 1
#endif
