gallicchio/GPiBridge/gen/routing.py

"""Copper on the board, inside KiCad's Python: fixed copper (zones, tracks
and vias given as coordinates), ground fan-out vias, and the grid router for
everything else.  Called by gen/board.py.

Every pad, track, via and zone is an *item*: its cells on the routing grid
and the obstacle it stamps for other nets.  A net is complete when its items
form one group, where items join if they share a cell on a common layer, and
every via or through-hole pad of GND joins the others through In1, the
unbroken ground plane.  Routing a net joins its groups one at a time, the
smallest first, with A* from that group to all the others.

Board millimetres throughout (board.P / board.B convert).  The routing grid's
layers: 0 = F.Cu, 1 = In2.Cu, 2 = B.Cu; In1.Cu is the ground plane.
"""
import math
import pcbnew
import router as R

LAYERS = [pcbnew.F_Cu, pcbnew.In2_Cu, pcbnew.B_Cu]
LIDX = {pcbnew.F_Cu: 0, pcbnew.In2_Cu: 1, pcbnew.B_Cu: 2}
VIA = (0.45, 0.25)                 # pad, drill: JLCPCB's standard 4-layer via
# Planes: a via or through-hole pad of the net, inside the polygon (board
# mm; None = everywhere), is joined through that plane.  GND is In1.Cu, solid;
# routes.py adds the bottom-layer supply pours.
PLANES = {"GND": None}


class Item:
    """cells: {layer: grid cells its copper covers}, for joining items;
    inner: where a routed track may end on it (a pad's cells far enough
    inside that a track ending there crosses the pad's edge at full width;
    any cell of a track, via or zone)."""
    __slots__ = ("net", "cells", "stamp", "plane", "what", "inner")

    def __init__(self, net, cells, stamp, plane, what, inner=None):
        self.net, self.cells, self.stamp, self.plane, self.what = net, cells, stamp, plane, what
        self.inner = inner if inner is not None else cells


class Router:
    def __init__(self, board, P, B, w, h):
        self.board, self.P, self.B = board, P, B
        self.g = R.Grid(w, h)
        self.items = []
        self.by_net = {}
        self.nets = {}
        for name, ni in board.GetNetsByName().items():
            if str(name):
                self.nets[str(name)] = ni
        self.failed = []
        self.n_tracks = self.n_vias = 0

    # ---- items ----------------------------------------------------------------
    def _item(self, net, shape, layers, plane=False, clear=R.CLEAR, what="", inner=None):
        c0 = self.g.shape_cells(shape, 0.0)
        cells = {L: set(c0) for L in layers}
        stamp = self.g.obstacle(shape, layers, clear)
        self.g.add(stamp)
        it = Item(net, cells, stamp, plane, what, {L: set(inner) for L in layers} if inner is not None else None)
        self.items.append(it)
        self.by_net.setdefault(net, []).append(len(self.items) - 1)
        return it

    def lift(self, net):
        for i in self.by_net.get(net, []):
            self.g.sub(self.items[i].stamp)

    def drop(self, net):
        for i in self.by_net.get(net, []):
            self.g.add(self.items[i].stamp)

    @staticmethod
    def pad_shape(pad, B):
        """("disc", x, y, r), ("seg", x0, y0, x1, y1, r) for an oval (the
        segment between its end circles' centres), or ("rect", x, y, hw, hh,
        angle) for the rest (a rounded rectangle's corners count as square)."""
        x, y = B(pad.GetPosition())
        sz = pad.GetSize(pcbnew.F_Cu)
        w, h = pcbnew.ToMM(sz.x), pcbnew.ToMM(sz.y)
        kind = pad.GetShape(pcbnew.F_Cu)
        ang = -pad.GetOrientationDegrees()
        if kind == pcbnew.PAD_SHAPE_CIRCLE or (kind == pcbnew.PAD_SHAPE_OVAL and abs(w - h) < 1e-6):
            return ("disc", x, y, w / 2)
        if kind == pcbnew.PAD_SHAPE_OVAL:
            # the long axis in the pad's frame, turned onto the board (the
            # inverse of the turn shape_cells applies to a rect)
            ca, sa = math.cos(math.radians(ang)), math.sin(math.radians(ang))
            if h > w:
                L = (h - w) / 2
                dx, dy = -L * sa, L * ca
            else:
                L = (w - h) / 2
                dx, dy = L * ca, L * sa
            return ("seg", x - dx, y - dy, x + dx, y + dy, min(w, h) / 2)
        return ("rect", x, y, w / 2, h / 2, ang)

    @staticmethod
    def pad_layers(pad):
        if pad.GetAttribute() == pcbnew.PAD_ATTRIB_PTH:
            return [0, 1, 2]
        return [LIDX[l] for l in LAYERS if pad.IsOnLayer(l)]

    def load_pads(self):
        """Every pad becomes an item; drills (plated or not) forbid vias nearby."""
        for fp in self.board.GetFootprints():
            for pad in fp.Pads():
                shape = self.pad_shape(pad, self.B)
                x, y = shape[1], shape[2]
                att = pad.GetAttribute()
                if att in (pcbnew.PAD_ATTRIB_PTH, pcbnew.PAD_ATTRIB_NPTH):
                    d = pcbnew.ToMM(pad.GetDrillSize().x)
                    # no via drill within 0.25 mm of this drill (hole to hole), any net
                    self._novia(x, y, d / 2 + VIA[1] / 2 + 0.25)
                if att == pcbnew.PAD_ATTRIB_NPTH:
                    d = pcbnew.ToMM(pad.GetDrillSize().x)
                    self._item("<npth>", ("disc", x, y, d / 2), [0, 1, 2], clear=0.25, what="npth")
                    continue
                layers = self.pad_layers(pad)
                if not layers:
                    continue
                net = pad.GetNetname() or "<nc:%s.%s>" % (fp.GetReference(), pad.GetNumber())
                self._item(net, shape, layers, plane=(att == pcbnew.PAD_ATTRIB_PTH),
                           what="%s.%s" % (fp.GetReference(), pad.GetNumber()), inner=self._inner_cells(shape))
                # no vias inside any pad (SMD or through hole), nor touching it
                self._novia_shape(shape, VIA[0] / 2 + 0.05)

    def _inner_cells(self, shape, m=0.075):
        """A pad's cells at least m inside its edge (half a 0.15 mm track), so
        a track ending there never meets the pad at a corner only (KiCad's
        connection-width check); a pad too small for that offers its centre."""
        if shape[0] == "disc":
            _, x, y, rad = shape
            cells = self.g._disc(x, y, rad - m) if rad > m else []
            cx, cy = x, y
        elif shape[0] == "seg":
            _, x0, y0, x1, y1, hw = shape
            cells = self.g.shape_cells(("seg", x0, y0, x1, y1, max(hw - m, 0.0)), 1e-4)
            cx, cy = (x0 + x1) / 2, (y0 + y1) / 2
        else:
            _, cx, cy, hw, hh, ang = shape
            cells = self.g.shape_cells(("rect", cx, cy, max(hw - m, 0.0), max(hh - m, 0.0), ang), 1e-4)
        return set(cells) or {self.g.k(cx, cy)}

    def _novia(self, x, y, r):
        for k in self.g._disc(x, y, r):
            self.g.novia[k] = 1

    def _novia_shape(self, shape, r):
        for k in self.g.shape_cells(shape, r):
            self.g.novia[k] = 1

    def keepout(self, x0, y0, x1, y1, layers, via=True):
        self.g.keepout(x0, y0, x1, y1, layers, via)

    # ---- adding copper ----------------------------------------------------------
    def track(self, net, L, a, b, width, stamp=True):
        t = pcbnew.PCB_TRACK(self.board)
        t.SetStart(self.P(*a)); t.SetEnd(self.P(*b))
        t.SetWidth(pcbnew.FromMM(width)); t.SetLayer(LAYERS[L])
        t.SetNet(self.nets[net])
        self.board.Add(t)
        self.n_tracks += 1
        if stamp:
            self._item(net, ("seg", a[0], a[1], b[0], b[1], width / 2), [L], what="track")
        return t

    def polyline(self, net, L, pts, width):
        for a, b in zip(pts, pts[1:]):
            if math.hypot(b[0] - a[0], b[1] - a[1]) > 1e-6:
                self.track(net, L, a, b, width)

    def via(self, net, x, y, size=VIA):
        v = pcbnew.PCB_VIA(self.board)
        v.SetPosition(self.P(x, y))
        v.SetWidth(pcbnew.FromMM(size[0])); v.SetDrill(pcbnew.FromMM(size[1]))
        v.SetViaType(pcbnew.VIATYPE_THROUGH)
        # no pad on an inner layer the via does not connect on: the ground plane
        # then comes 0.2 mm from the drill instead of from a pad, and two vias
        # that touch on a layer they do not use make no narrow copper there
        v.Padstack().SetUnconnectedLayerMode(pcbnew.UNCONNECTED_LAYER_MODE_REMOVE_EXCEPT_START_AND_END)
        v.SetNet(self.nets[net])
        self.board.Add(v)
        self.n_vias += 1
        self._item(net, ("disc", x, y, size[0] / 2), [0, 1, 2], plane=True, what="via")
        self._novia(x, y, size[1] / 2 + VIA[1] / 2 + 0.25)
        return v

    def zone(self, net, layer, pts, priority=0, clearance=0.15, min_width=0.15, connect="thermal",
             name=None, item=True, spoke=0.25, gap=0.2):
        """A copper pour.  With item=True its outline's inside is also a
        routing item: other nets keep clear of it, its own net may join it."""
        z = pcbnew.ZONE(self.board)
        z.SetLayer(layer)
        z.SetNet(self.nets[net])
        z.SetAssignedPriority(priority)
        z.SetLocalClearance(pcbnew.FromMM(clearance))
        z.SetMinThickness(pcbnew.FromMM(min_width))
        z.SetPadConnection({"thermal": pcbnew.ZONE_CONNECTION_THERMAL,
                            "solid": pcbnew.ZONE_CONNECTION_FULL}[connect])
        z.SetThermalReliefGap(pcbnew.FromMM(gap))
        z.SetThermalReliefSpokeWidth(pcbnew.FromMM(spoke))
        if name:
            z.SetZoneName(name)
        ol = z.Outline()
        ol.NewOutline()
        for x, y in pts:
            ol.Append(self.P(x, y))
        self.board.Add(z)
        if item and layer in LIDX:
            self._poly_item(net, LIDX[layer], pts)
        return z

    def _poly_item(self, net, L, pts):
        xs, ys = [p[0] for p in pts], [p[1] for p in pts]
        i0, j0 = self.g.cell(min(xs), min(ys))
        i1, j1 = self.g.cell(max(xs), max(ys))
        inside = []
        for j in range(max(0, j0), min(self.g.ny - 1, j1) + 1):
            for i in range(max(0, i0), min(self.g.nx - 1, i1) + 1):
                if point_in_poly(i * R.PITCH, j * R.PITCH, pts):
                    inside.append(j * self.g.nx + i)
        stamp = {}
        inset = set(inside)
        for c in R.CLS:
            r = R.CLEAR + R.CLASSES[c]
            n = int(math.ceil(r / R.PITCH))
            grown = set()
            # only the border cells need growing
            for k in inside:
                i, j = k % self.g.nx, k // self.g.nx
                if all(((j + dj) * self.g.nx + i + di) in inset for di, dj in ((1, 0), (-1, 0), (0, 1), (0, -1))):
                    grown.add(k)
                    continue
                for di in range(-n, n + 1):
                    for dj in range(-n, n + 1):
                        if (di * di + dj * dj) * R.PITCH * R.PITCH <= r * r:
                            ii, jj = i + di, j + dj
                            if 0 <= ii < self.g.nx and 0 <= jj < self.g.ny:
                                grown.add(jj * self.g.nx + ii)
            stamp[(L, c)] = list(grown)
        self.g.add(stamp)
        it = Item(net, {L: inset}, stamp, False, "zone")
        self.items.append(it)
        self.by_net.setdefault(net, []).append(len(self.items) - 1)

    # ---- connectivity ---------------------------------------------------------
    def groups(self, net):
        ids = self.by_net.get(net, [])
        parent = {i: i for i in ids}

        def find(a):
            while parent[a] != a:
                parent[a] = parent[parent[a]]
                a = parent[a]
            return a

        def union(a, b):
            ra, rb = find(a), find(b)
            if ra != rb:
                parent[ra] = rb

        owner = {}
        first_plane = None
        poly = PLANES.get(net, False)
        for i in ids:
            it = self.items[i]
            if it.plane and poly is not False and (poly is None or self._inside(it, poly)):
                if first_plane is None:
                    first_plane = i
                else:
                    union(i, first_plane)
            for L, cells in it.cells.items():
                for k in cells:
                    o = owner.get((L, k))
                    if o is None:
                        owner[(L, k)] = i
                    else:
                        union(i, o)
        out = {}
        for i in ids:
            out.setdefault(find(i), []).append(i)
        return list(out.values())

    def _inside(self, it, poly):
        cells = next(iter(it.cells.values()))
        k = next(iter(cells))
        x, y = self.g.pos(k)
        return point_in_poly(x, y, poly)

    def cells_of(self, ids, layers=None, inner=False):
        s = set()
        for i in ids:
            for L, cells in (self.items[i].inner if inner else self.items[i].cells).items():
                if layers is None or L in layers:
                    for k in cells:
                        s.add((L, k))
        return s

    def unrouted(self, net):
        return len(self.groups(net)) - 1

    # ---- routing --------------------------------------------------------------
    def route_net(self, net, width, layers=(0, 1, 2), layer_cost=None, via_cost=R.VIA_COST,
                  max_pop=1500000, allow_via=True, bbox_margin=None):
        cls = R.width_class(width)
        tries = 0
        while True:
            groups = self.groups(net)
            if len(groups) < 2:
                return True
            groups.sort(key=lambda g: len(self.cells_of(g)))
            src = groups[0]
            others = [i for g in groups[1:] for i in g]
            starts = self.cells_of(src, layers, inner=True)
            goals = self.cells_of(others, layers, inner=True)
            if not starts or not goals:
                self.failed.append((net, "no cells on the allowed layers"))
                return False
            bbox = None
            if bbox_margin is not None:
                pts = [self.g.pos(k) for _, k in list(starts) + list(goals)]
                m = bbox_margin
                bbox = (max(0, int((min(p[0] for p in pts) - m) / R.PITCH)),
                        max(0, int((min(p[1] for p in pts) - m) / R.PITCH)),
                        min(self.g.nx - 1, int((max(p[0] for p in pts) + m) / R.PITCH)),
                        min(self.g.ny - 1, int((max(p[1] for p in pts) + m) / R.PITCH)))
            self.lift(net)
            try:
                path = self.g.route(starts, goals, cls, layers=layers, allow_via=allow_via, max_pop=max_pop,
                                    bbox=bbox, via_cost=via_cost, layer_cost=layer_cost)
            finally:
                self.drop(net)
            if path is None:
                what = ",".join(sorted(self.items[i].what for i in src if self.items[i].what not in ("track", "via")))
                self.failed.append((net, "from %s" % (what or "a track")))
                return False
            self.lay(net, path, width)
            tries += 1
            if tries > 60:
                self.failed.append((net, "too many pieces"))
                return False

    def lay(self, net, path, width):
        segs, vias = R.simplify(path, self.g.nx)
        for (L, x0, y0, x1, y1) in segs:
            self.track(net, L, (x0, y0), (x1, y1), width)
        for (x, y) in vias:
            self.via(net, x, y)

    def fanout(self, net, pad_items=None, reach=1.6, width=0.25, skip=()):
        """A via beside every SMD pad of `net` that does not already reach
        it through copper: a short track from the pad to the nearest spot where
        a via fits.  For GND every via joins In1."""
        made = 0
        for i in list(self.by_net.get(net, [])):
            it = self.items[i]
            if it.plane or it.what in ("track", "via", "zone") or not it.what:
                continue
            if pad_items is not None and it.what not in pad_items:
                continue
            if any(it.what.startswith(p) for p in skip):
                continue
            if self._reaches_plane(net, i):
                continue
            spot = self._via_spot(net, it, reach, width)
            if spot is None:
                continue                          # the router joins it to the net later
            path, (x, y) = spot
            if len(path) > 1:
                self.lay(net, path, width)
            self.via(net, x, y)
            made += 1
        return made

    def _reaches_plane(self, net, i):
        poly = PLANES.get(net, False)
        if poly is False:
            return False
        for g in self.groups(net):
            if i in g:
                return any(self.items[j].plane and (poly is None or self._inside(self.items[j], poly)) for j in g)
        return False

    def _via_spot(self, net, it, reach, width):
        """Breadth-first from the pad's cells on F.Cu to the nearest cell
        where a via of `net` fits; returns (path, (x, y))."""
        cls = R.width_class(width)
        L = min(it.cells)
        self.lift(net)
        try:
            gl = self.g.g[(L, cls)]
            vg = [self.g.g[(LL, "via")] for LL in range(R.NL)]
            start = list(it.cells[L])
            sx = sum(self.g.pos(k)[0] for k in start) / len(start)
            sy = sum(self.g.pos(k)[1] for k in start) / len(start)
            par = {k: None for k in start}
            frontier = list(start)
            nx = self.g.nx
            maxd = reach / R.PITCH
            while frontier:
                nxt = []
                # nearest-first inside a ring: sort by distance from the pad centre
                frontier.sort(key=lambda k: (self.g.pos(k)[0] - sx) ** 2 + (self.g.pos(k)[1] - sy) ** 2)
                poly = PLANES.get(net)
                for k in frontier:
                    if k not in it.cells[L] and not self.g.novia[k] and all(not v[k] for v in vg) \
                            and not any(self.g.keep[LL][k] for LL in range(R.NL)) \
                            and (not poly or point_in_poly(*self.g.pos(k), poly)):
                        path = []
                        c = k
                        while c is not None:
                            path.append((L, c))
                            c = par[c]
                        path.reverse()
                        # start the track at the pad's centre cell
                        ck = self.g.k(sx, sy)
                        if ck in it.cells[L] and path[0][1] != ck:
                            path.insert(0, (L, ck))
                        return path, self.g.pos(k)
                for k in frontier:
                    i, j = k % nx, k // nx
                    for di, dj in ((1, 0), (-1, 0), (0, 1), (0, -1), (1, 1), (1, -1), (-1, 1), (-1, -1)):
                        ii, jj = i + di, j + dj
                        if not (0 <= ii < nx and 0 <= jj < self.g.ny):
                            continue
                        kk = jj * nx + ii
                        if kk in par or gl[kk] or self.g.keep[L][kk]:
                            continue
                        if (ii - sx / R.PITCH) ** 2 + (jj - sy / R.PITCH) ** 2 > maxd * maxd:
                            continue
                        par[kk] = k
                        nxt.append(kk)
                frontier = nxt
        finally:
            self.drop(net)
        return None


def stamp(R, net, width, x0, y0, x1, y1):
    """The router's view of a window, for looking at why a net failed: per
    layer, 0 free, 1 blocked for this net's track width, 2 the net's own
    copper; and where a via would fit."""
    import router as RR
    cls = RR.width_class(width)
    i0, j0 = R.g.cell(x0, y0)
    i1, j1 = R.g.cell(x1, y1)
    own = R.cells_of(R.by_net.get(net, []))
    R.lift(net)
    try:
        layers = []
        for L in range(RR.NL):
            g = R.g.g[(L, cls)]
            rows = []
            for j in range(j0, j1 + 1):
                row = []
                for i in range(i0, i1 + 1):
                    k = j * R.g.nx + i
                    row.append(2 if (L, k) in own else (1 if (g[k] or R.g.keep[L][k]) else 0))
                rows.append(row)
            layers.append(rows)
        via = []
        vg = [R.g.g[(L, "via")] for L in range(RR.NL)]
        for j in range(j0, j1 + 1):
            via.append([0 if (not R.g.novia[j * R.g.nx + i] and all(not v[j * R.g.nx + i] for v in vg)) else 1
                        for i in range(i0, i1 + 1)])
    finally:
        R.drop(net)
    return dict(net=net, width=width, x0=i0 * RR.PITCH, y0=j0 * RR.PITCH, pitch=RR.PITCH, layers=layers, via=via)


def point_in_poly(x, y, pts):
    inside = False
    n = len(pts)
    for i in range(n):
        x0, y0 = pts[i]
        x1, y1 = pts[(i + 1) % n]
        if (y0 > y) != (y1 > y):
            xc = x0 + (y - y0) * (x1 - x0) / (y1 - y0)
            if x < xc:
                inside = not inside
    return inside
