gallicchio/GPiBridge/firmware/src/tusb_config.h

/* tusb_config.h: TinyUSB for GPiBridge: a full-speed device with two CDC
 * serial ports (GPIB, console) and Raspberry Pi's reset interface (vendor
 * class, for `picotool reboot`).  See usb_descriptors.c. */
#pragma once

#define CFG_TUSB_RHPORT0_MODE   (OPT_MODE_DEVICE | OPT_MODE_FULL_SPEED)
#define CFG_TUSB_OS             OPT_OS_PICO
#define CFG_TUD_ENDPOINT0_SIZE  64

#define CFG_TUD_CDC             2
#define CFG_TUD_MSC             0
#define CFG_TUD_HID             0
#define CFG_TUD_MIDI            0
#define CFG_TUD_VENDOR          0

#define CFG_TUD_CDC_RX_BUFSIZE  1024
#define CFG_TUD_CDC_TX_BUFSIZE  1024
#define CFG_TUD_CDC_EP_BUFSIZE  64
