gallicchio/GPiBridge/(commit log)

2026-10-07 GPiBridge and GPiBridge Lite rev A: ordered, not yet received
    An open USB-C to GPIB (IEEE-488) adapter, by Jason Gallicchio and Claude,
    designed in a Claude Code conversation (CLAUDE_CODE_CHAT.md, Prompts 1-9)
    inside the private OpticsPCBs repository and moved here whole.
    - hardware/: KiCad 10 schematics and boards for GPiBridge (SN75160B and
    SN75161B transceivers) and GPiBridge Lite (100 R per line, open-drain),
    written by the generators in gen/. ERC 0, and DRC 0 at every severity
    with schematic parity.
    - mfg/release, mfg/release-lite: the JLCPCB releases. Both boards were
    ordered on 2026-10-06, 5 of each with 2 assembled.
    - enclosure/: the two-part housing, drawn in FreeCAD for MJ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
    [GPiBridge-B_Cu.gbr, GPiBridge-B_Mask.gbr, GPiBridge-B_Paste.gbr, GPiBridge-B_Silkscreen.gbr, GPiBridge-Edge_Cuts.gbr, GPiBridge-F_Cu.gbr, GPiBridge-F_Mask.gbr, GPiBridge-F_Paste.gbr]
2026-10-18 Release CPLs renamed _cpl_jlcpcb_upload / _cpl_kicad_native in both releases; the notes say which to upload (Prompt 10)
    The four CPLs are byte for byte what was ordered on 2026-10-06, under their new names; make_release.py
    writes the names, FABRICATION_NOTES.txt and PLACEMENT_CHECKS.txt use them; the cost estimates re-fetched
    JLCPCB's stock (2026-10-08). Staged by Response 10 on 2026-10-08, committed with Prompt 11.
    Claude-Session: https://claude.ai/code/session_01QMvDbUyTYmsZQSJzH43Peb
    [cost_estimate.csv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]
2026-10-18 Rev A's L1 substituted by JLCPCB after the order: TDK VLS201612HBX-3R3M-1 (C2042572) for the AOTA; the design keeps the AOTA (Prompt 11)
    JLCPCB ran out of C42411119 (3 for 4 boards, 2026-10-18) and asked for a replacement; Jason chose
    C2042572 (3.3 uH, 1.57 A, 174 mOhm, 2016 land, unpolarised). Recorded in gen/parts.py's note,
    DESIGN_NOTES 2.8 and risk 8 (what the bring-up measures), BRINGUP stages 0 and 1, README's status, a
    comment in jlc_rotation.py, and the lesson in CLAUDE_PCB.md section 3. Nothing in the design changed.
    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
    [jlc_rotation.py, parts.py]
